Malibushko/TrackNode/applications/win/preview.png

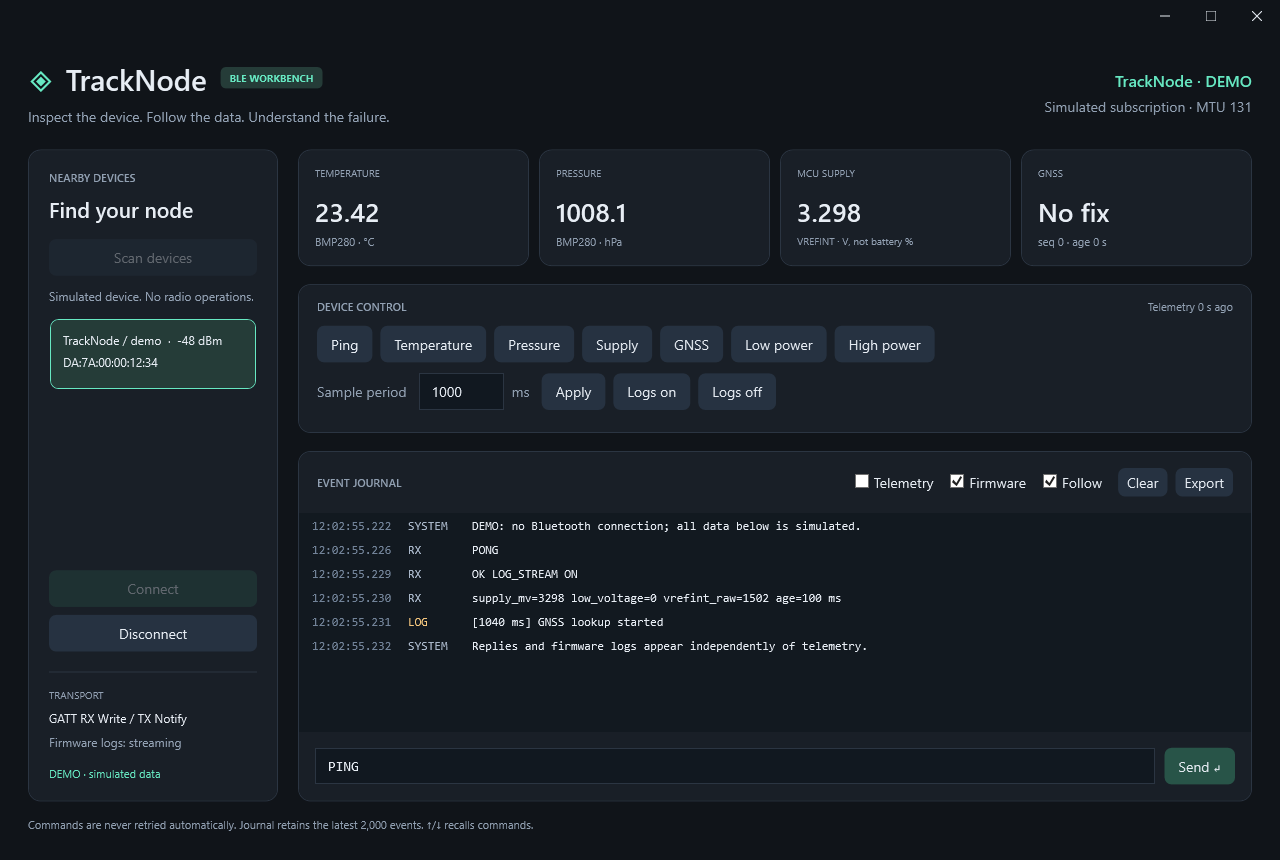
applications/win/preview.png
