Malibushko/TrackNode/hardware/enclosure/tracknode-explode.gif

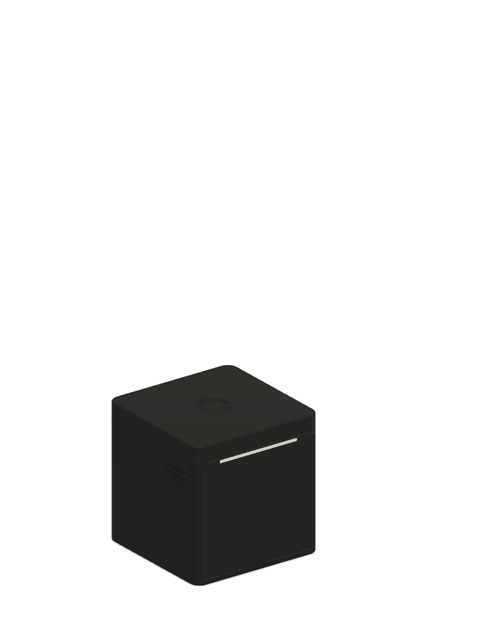
hardware/enclosure/tracknode-explode.gif
