Malibushko/TrackNode/hardware/enclosure/step/tracknode-main-board.step

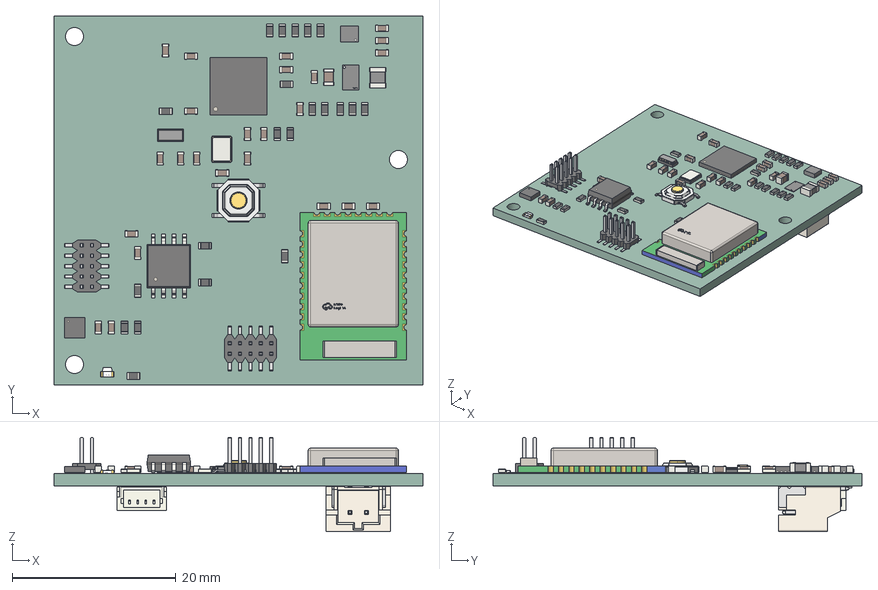
[picture p3: CAD file, 2026-10-30]
hardware/enclosure/step/tracknode-main-board.step
45.0 x 45.0 x 11.5 mm
LED-SMD_L1.7-W0.6-H1.2
R_0603_1608Metric x 21
HDR-SMD_10P-P1.27-M-LS-2X5P x 2
C_0603_1608Metric x 24
Crystal_SMD_3225-4Pin_3.2x2.5mm
Bosch_LGA_8_25x25mm_P065mm_ClockwisePinNumbering
C_0805_2012Metric
L_1008_2520Metric
WSON-10_L2.2-W2.0-P0.40-BL-EP_TI_DLH0010A
QFN-48-1EP_7x7mm_Pitch0.5mm
SOIC-8_5.3x5.3mm_P1.27mm
WIRELM-SMD_L18.0-W13.0-H3.0-E73-2G4M08S1C
Crystal_SMD_3215-2Pin_3.2x1.5mm
VSON-10_L3.0-W2.0-P0.50-TL
SW-SMD_4P-L5.1-W5.1-P3.70-LS6.5-TL_H1.5
JST_SH_SM04B-SRSS-TB_1x04-1MP_P1.00mm_Horizontal
CONN-SMD_P2.00_S2B-PH-SM4-TB-LF-SN
track-node_PCB
