Malibushko/TrackNode/hardware/enclosure/stl/tracknode-lid.stl

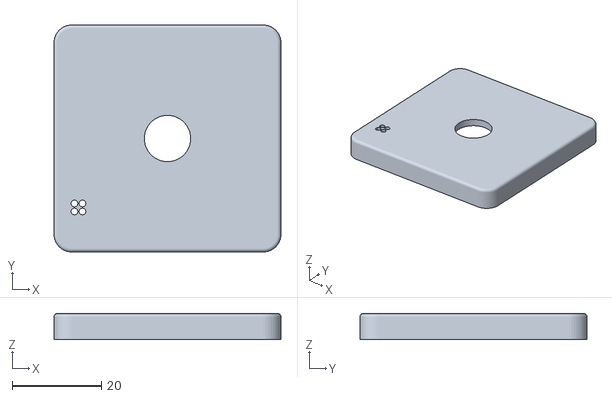
[picture p4: CAD file, 2026-10-30]
hardware/enclosure/stl/tracknode-lid.stl
51.0 x 51.0 x 5.90
