Malibushko/TrackNode/hardware/enclosure/step/tracknode-usb-board.step

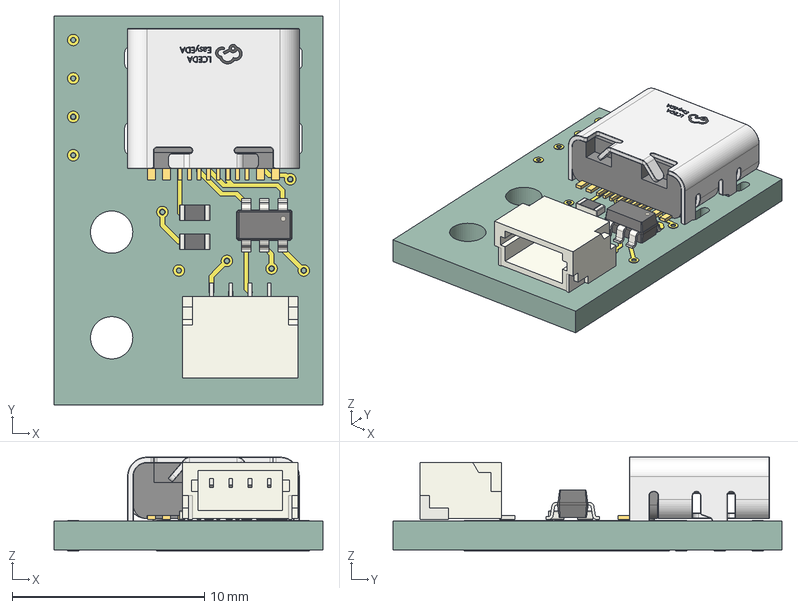
[picture p5: CAD file, 2026-10-30]
hardware/enclosure/step/tracknode-usb-board.step
14.0 x 20.2 x 4.88 mm
R_0603_1608Metric x 2
USB-C_SMD-TYPE-C-31-M-12
JST_SH_SM04B-SRSS-TB_1x04-1MP_P1.00mm_Horizontal
SOT-23-6
track-node-usb_copper
track-node-usb_via
track-node-usb_PCB
