Malibushko/TrackNode/hardware/enclosure/stl/tracknode-light-bar.stl

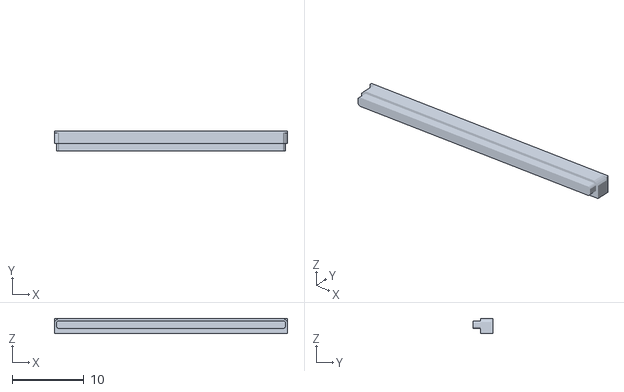
[picture p6: CAD file, 2026-10-30]
hardware/enclosure/stl/tracknode-light-bar.stl
32.4 x 2.75 x 2.05
