Malibushko/TrackNode/hardware/enclosure/stl/tracknode-battery-strap.stl

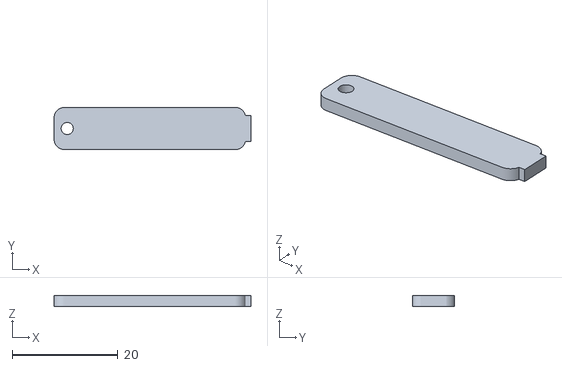
[picture p7: CAD file, 2026-10-30]
hardware/enclosure/stl/tracknode-battery-strap.stl
37.3 x 8.00 x 2.00
