Malibushko/TrackNode/hardware/enclosure/stl/tracknode-button-cap.stl

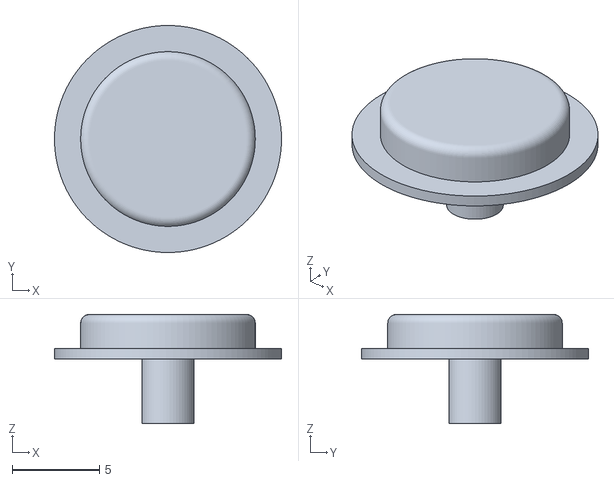
[picture p8: CAD file, 2026-10-30]
hardware/enclosure/stl/tracknode-button-cap.stl
13.0 x 13.0 x 6.25
