Malibushko/TrackNode/hardware/enclosure/stl/tracknode-front-plate.stl

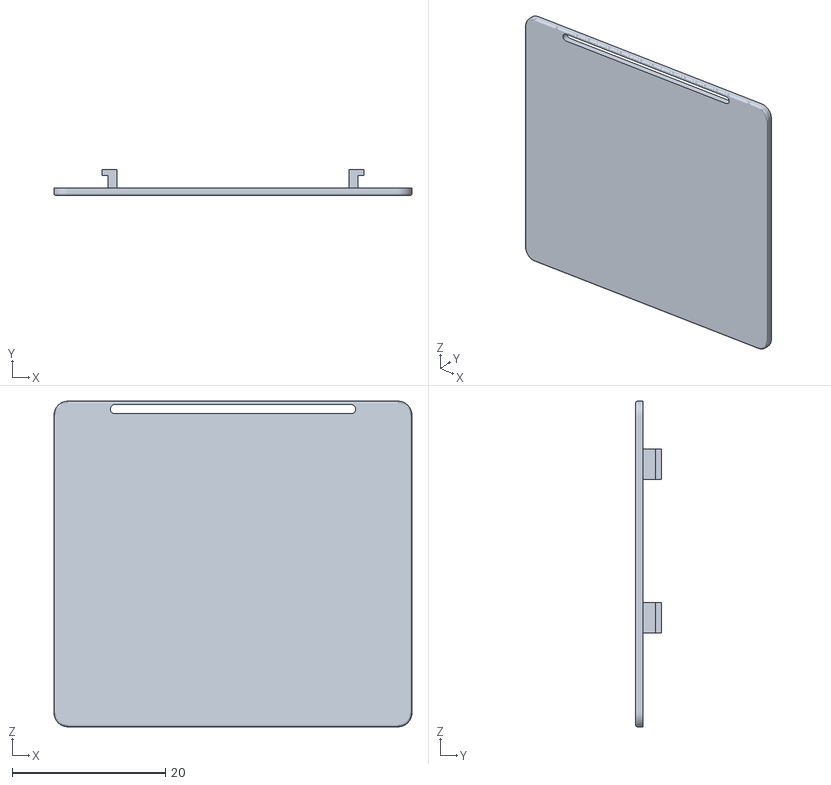
[picture p9: CAD file, 2026-10-30]
hardware/enclosure/stl/tracknode-front-plate.stl
46.7 x 3.40 x 42.5
