Malibushko/TrackNode/hardware/enclosure/stl/tracknode-body.stl

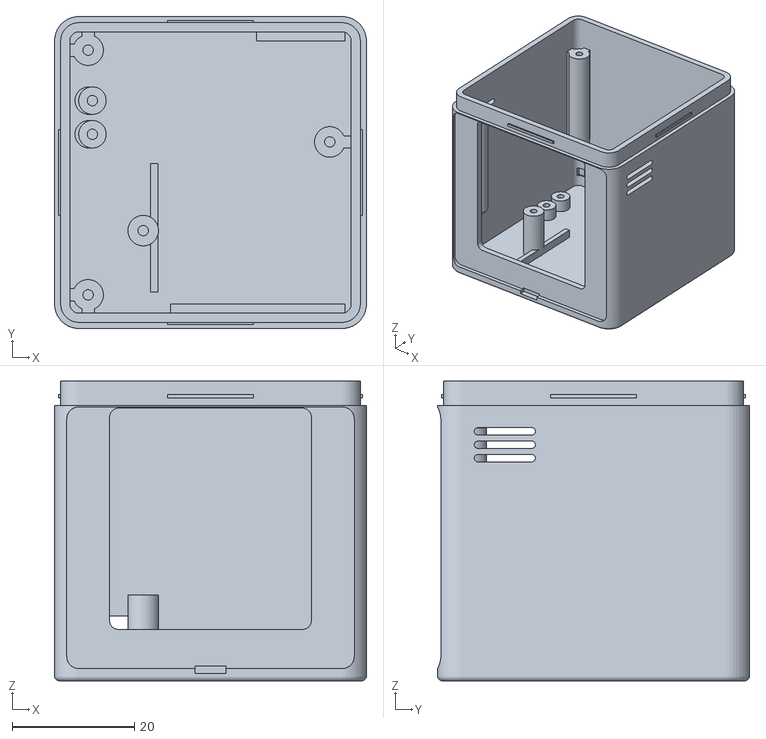
[picture p10: CAD file, 2026-10-30]
hardware/enclosure/stl/tracknode-body.stl
51.0 x 51.0 x 49.0
