Malibushko/TrackNode/(list of files, cad)

Other CAD files:
hardware/enclosure/tracknode-enclosure.f3d
