Malibushko/TrackNode/hardware/kicad/track-node-usb/track-node-usb.kicad_pcb

## KiCad design hardware/kicad/track-node-usb/track-node-usb.kicad_pcb (2026-10-30)

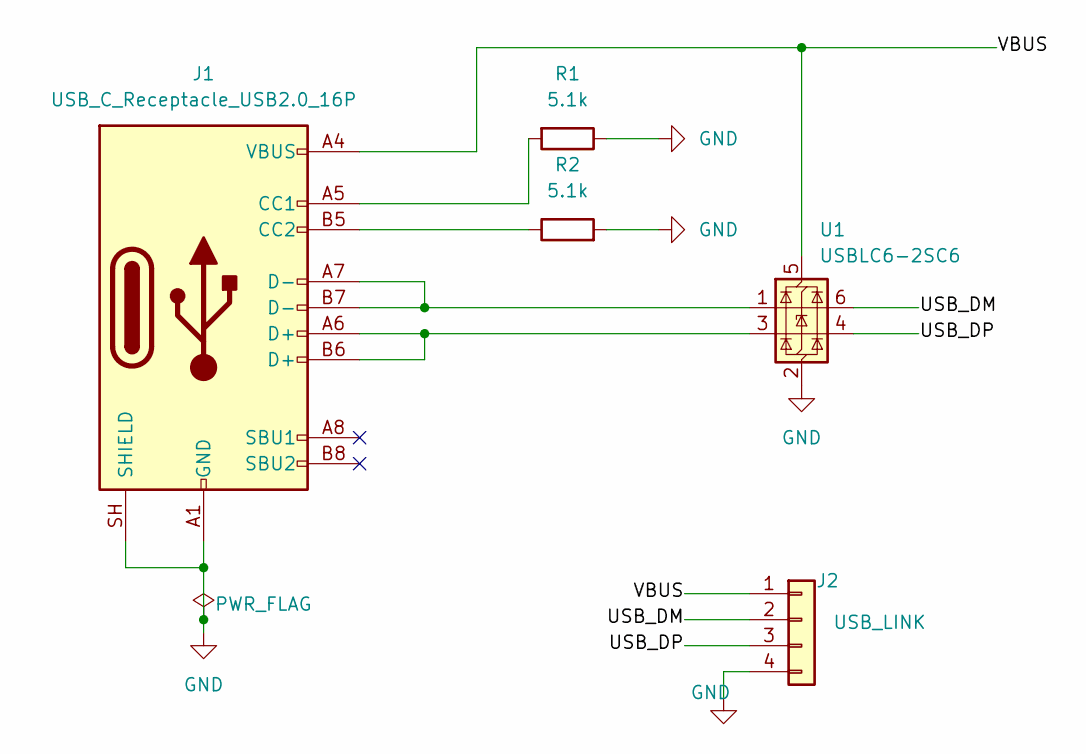
[picture p11: schematic track-node-usb.kicad_sch]

Parts:
J1: USB_C_Receptacle_USB2.0_16P; USB_C_Receptacle_HRO_TYPE-C-31-M-12_Edge; LCSC C165948
J2: USB_LINK; JST_SH_SM04B-SRSS-TB_1x04-1MP_P1.00mm_Horizontal; LCSC C160404
R1, R2: 5.1k; R_0603_1608Metric; LCSC C23186
U1: USBLC6-2SC6; SOT-23-6; LCSC C7519

Connections:
/USB_DM: J2.2, U1.6 (I/O1)
/USB_DP: J2.3, U1.4 (I/O2)
/VBUS: J1.A4 (VBUS), J1.A9 (VBUS), J1.B4 (VBUS), J1.B9 (VBUS), J2.1, U1.5 (VBUS)
GND: J1.A1 (GND), J1.A12 (GND), J1.B1 (GND), J1.B12 (GND), J1.SH (SHIELD), J2.4, R1.1, R2.2, U1.2 (GND)
unnamed: J1.A5 (CC1), R1.2
unnamed: J1.B5 (CC2), R2.1
unnamed: J1.A6 (D+), J1.B6 (D+), U1.3 (I/O2)
unnamed: J1.A7 (D-), J1.B7 (D-), U1.1 (I/O1)

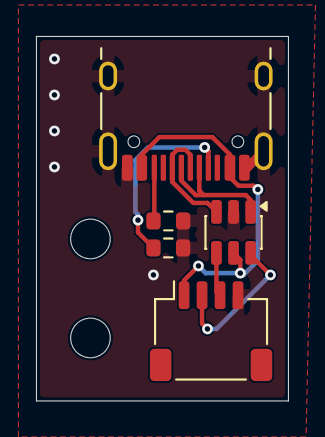
[picture p12: board track-node-usb.kicad_pcb from above]

Board: 2 copper layers, 14.0 x 20.2 mm, 5 parts (0 on the bottom side), 8 nets.
