Malibushko/TrackNode/hardware/kicad/track-node/track-node.kicad_pcb

## KiCad design hardware/kicad/track-node/track-node.kicad_pcb (2026-10-30)

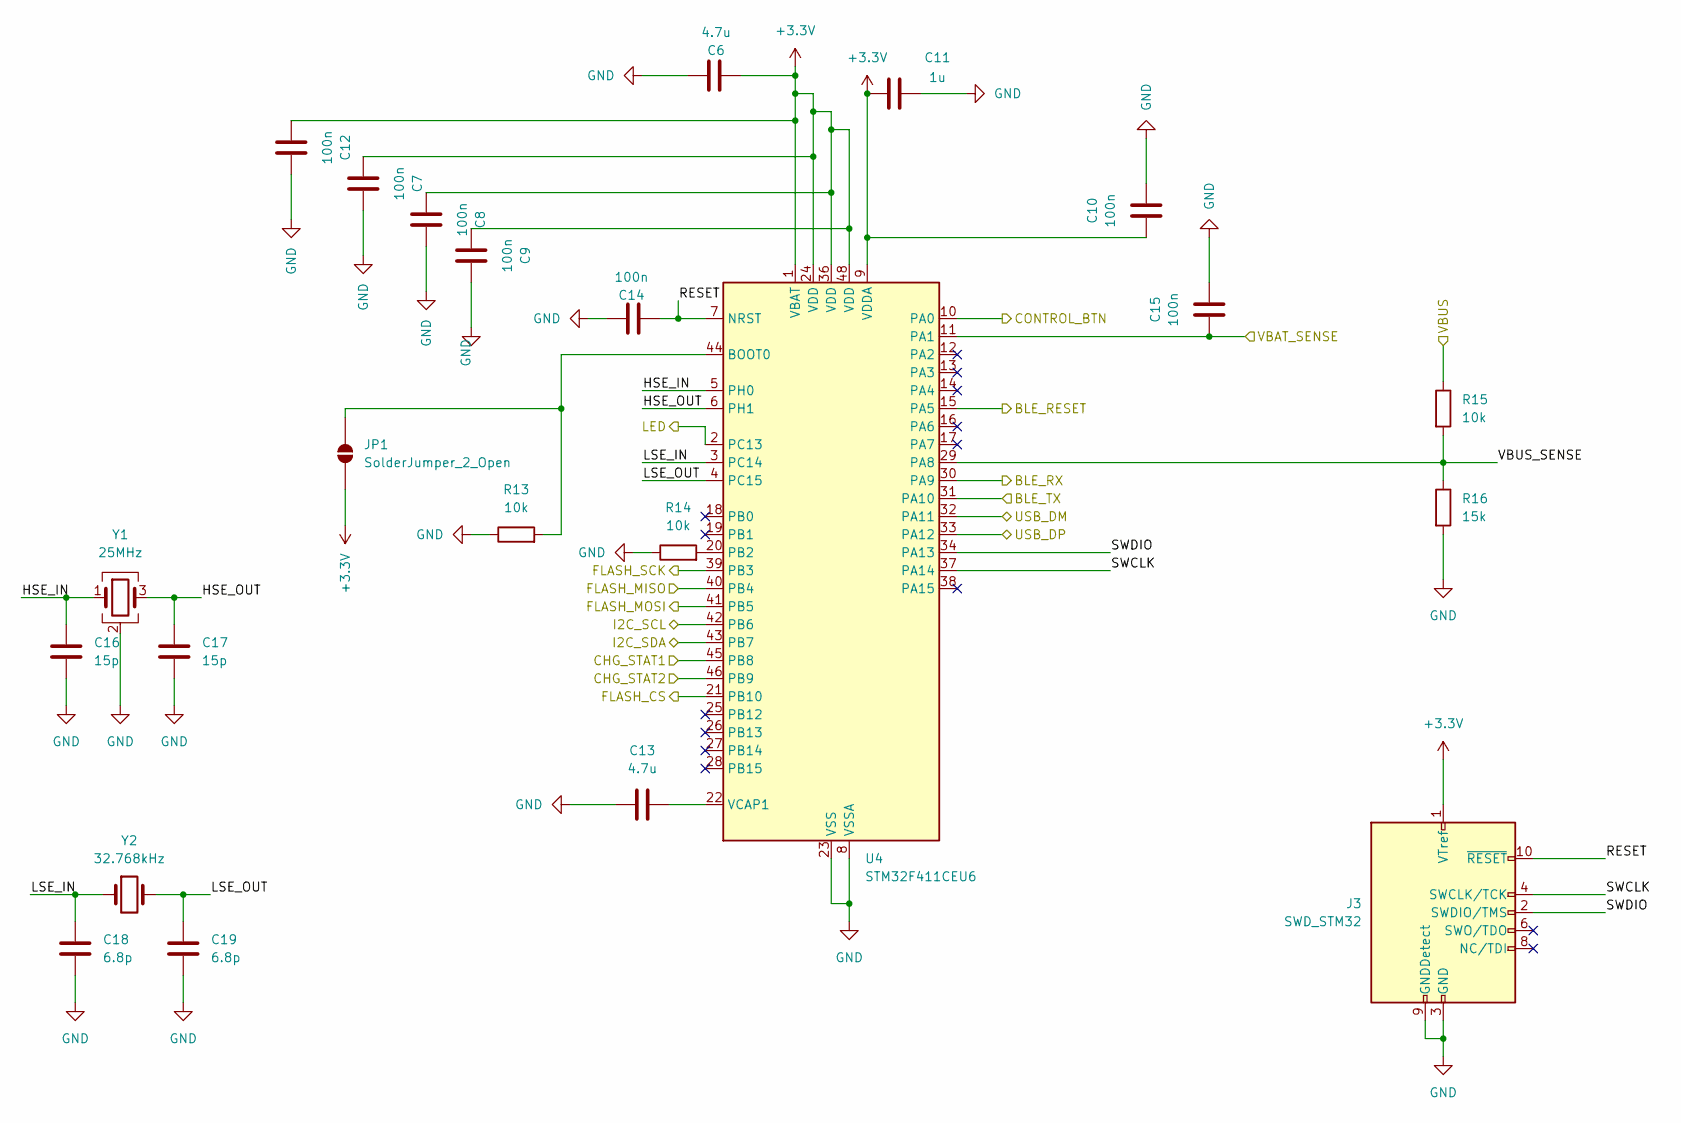
[picture p13: schematic MCU.kicad_sch]

Parts:
C6, C13: 4.7u; C_0603_1608Metric; LCSC C19666
C7, C8, C9, C10, C12, C14, C15: 100n; C_0603_1608Metric; LCSC C14663
C11: 1u; C_0603_1608Metric; LCSC C15849
C16, C17: 15p; C_0603_1608Metric; LCSC C1644
C18, C19: 6.8p; C_0603_1608Metric; LCSC C1679
J3: SWD_STM32; HDR-SMD_10P-P1.27-V-M-R2-C5-S1.27-LS5.5; LCSC C598540
JP1: SolderJumper_2_Open; SolderJumper-2_P1.3mm_Open_RoundedPad1.0x1.5mm
R13, R14, R15: 10k; R_0603_1608Metric; LCSC C25804
R16: 15k; R_0603_1608Metric; LCSC C22809
U4: STM32F411CEU6; QFN-48-1EP_7x7mm_P0.5mm_EP5.6x5.6mm; LCSC C60420
Y1: 25MHz; Crystal_SMD_3225-4Pin_3.2x2.5mm; LCSC C9006
Y2: 32.768kHz; Crystal_SMD_3215-2Pin_3.2x1.5mm; LCSC C276424

Connections:
+3.3V: C6.2, C7.2, C8.2, C9.2, C10.2, C11.2, C12.2, J3.1 (VTref), JP1.1 (A), U4.1 (VBAT), U4.9 (VDDA), U4.24 (VDD), U4.36 (VDD), U4.48 (VDD); also elsewhere on the board
/BLE/BLE_RESET: U4.15 (PA5); also elsewhere on the board
/BLE/BLE_RX: U4.30 (PA9); also elsewhere on the board
/BLE/BLE_TX: U4.31 (PA10); also elsewhere on the board
/MCU/CHG_STAT1: U4.45 (PB8); also elsewhere on the board
/MCU/CHG_STAT2: U4.46 (PB9); also elsewhere on the board
/MCU/CONTROL_BTN: U4.10 (PA0); also elsewhere on the board
/MCU/FLASH_CS: U4.21 (PB10); also elsewhere on the board
/MCU/FLASH_MISO: U4.40 (PB4); also elsewhere on the board
/MCU/FLASH_MOSI: U4.41 (PB5); also elsewhere on the board
/MCU/FLASH_SCK: U4.39 (PB3); also elsewhere on the board
/MCU/HSE_IN: C16.1, U4.5 (PH0), Y1.1
/MCU/HSE_OUT: C17.1, U4.6 (PH1), Y1.3
/MCU/I2C_SCL: U4.42 (PB6); also elsewhere on the board
/MCU/I2C_SDA: U4.43 (PB7); also elsewhere on the board
/MCU/LED: U4.2 (PC13); also elsewhere on the board
/MCU/LSE_IN: C18.1, U4.3 (PC14), Y2.1
/MCU/LSE_OUT: C19.1, U4.4 (PC15), Y2.2
/MCU/RESET: C14.2, J3.10 (~RESET), U4.7 (NRST)
/MCU/SWCLK: J3.4 (SWCLK/TCK), U4.37 (PA14)
/MCU/SWDIO: J3.2 (SWDIO/TMS), U4.34 (PA13)
/MCU/USB_DM: U4.32 (PA11); also elsewhere on the board
/MCU/USB_DP: U4.33 (PA12); also elsewhere on the board
/MCU/VBAT_SENSE: C15.2, U4.11 (PA1); also elsewhere on the board
/MCU/VBUS: R15.1; also elsewhere on the board
/MCU/VBUS_SENSE: R15.2, R16.1, U4.29 (PA8)
GND: C6.1, C7.1, C8.1, C9.1, C10.1, C11.1, C12.1, C13.1, C14.1, C15.1, C16.2, C17.2, C18.2, C19.2, J3.3 (GND), J3.5 (GND), J3.9 (GNDDetect), R13.1, R14.1, R16.2, U4.8 (VSSA), U4.23 (VSS), U4.35 (VSS), U4.47 (VSS), U4.49 (VSS), Y1.2 (G), Y1.4 (G); also elsewhere on the board
unnamed: JP1.2 (B), R13.2, U4.44 (BOOT0)
unnamed: R14.2, U4.20 (PB2)
unnamed: C13.2, U4.22 (VCAP1)

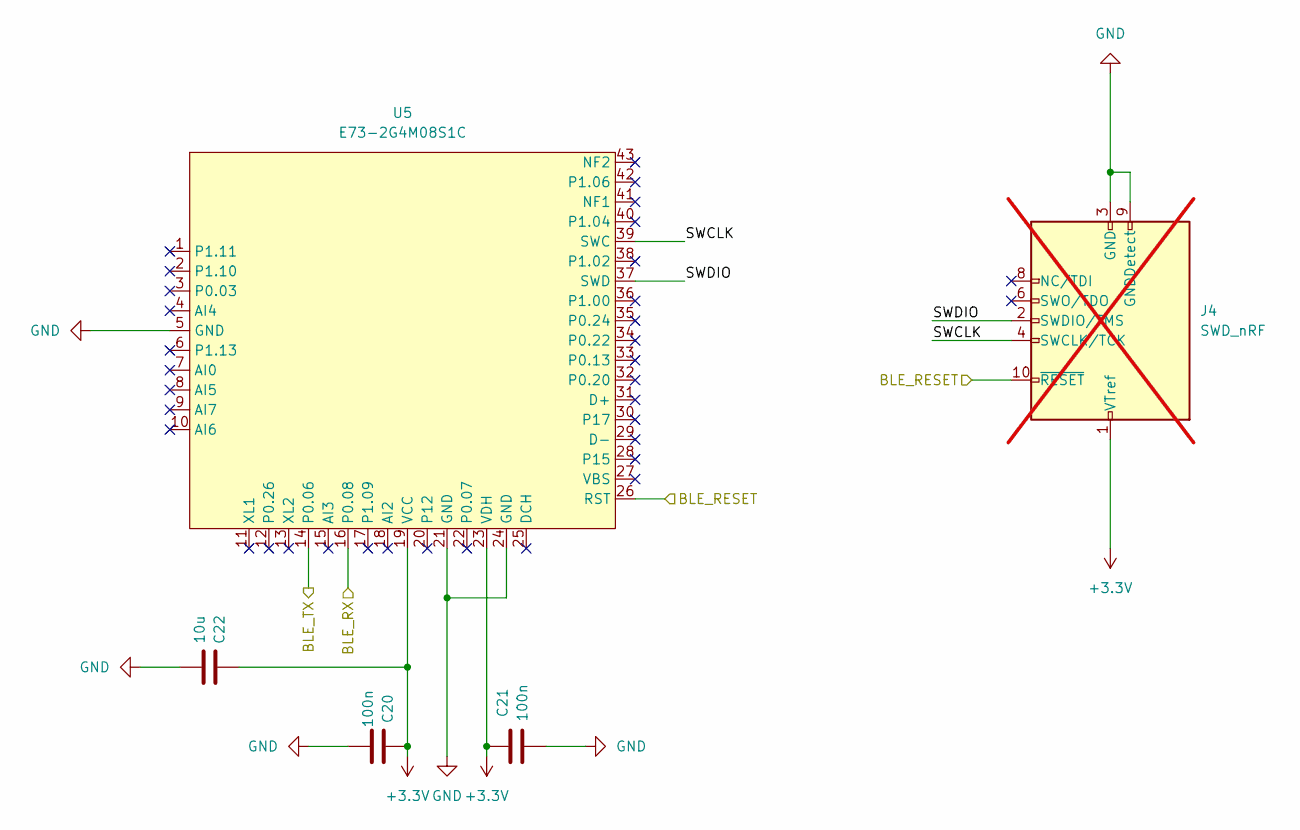
[picture p14: schematic BLE.kicad_sch]

Parts:
C20, C21: 100n; C_0603_1608Metric; LCSC C14663
C22: 10u; C_0603_1608Metric; LCSC C19702
J4: SWD_nRF; HDR-SMD_10P-P1.27-V-M-R2-C5-S1.27-LS5.5; not fitted
U5: E73-2G4M08S1C; WIRELM-SMD_E73-2G4M08S1C; MPN E73-2G4M08S1C; LCSC Part C356849

Connections:
+3.3V: C20.2, C21.2, C22.2, J4.1 (VTref), U5.19 (VCC), U5.23 (VDH); also elsewhere on the board
/BLE/BLE_RESET: J4.10 (~RESET), U5.26 (RST); also elsewhere on the board
/BLE/BLE_RX: U5.16 (P0.08); also elsewhere on the board
/BLE/BLE_TX: U5.14 (P0.06); also elsewhere on the board
/BLE/SWCLK: J4.4 (SWCLK/TCK), U5.39 (SWC)
/BLE/SWDIO: J4.2 (SWDIO/TMS), U5.37 (SWD)
GND: C20.1, C21.1, C22.1, J4.3 (GND), J4.5 (GND), J4.9 (GNDDetect), U5.5 (GND), U5.21 (GND), U5.24 (GND); also elsewhere on the board

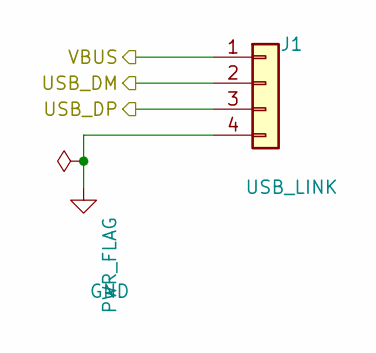
[picture p15: schematic USB.kicad_sch]

Parts:
J1: USB_LINK; JST_SH_SM04B-SRSS-TB_1x04-1MP_P1.00mm_Horizontal; LCSC C160404

Connections:
/MCU/USB_DM: J1.2; also elsewhere on the board
/MCU/USB_DP: J1.3; also elsewhere on the board
/MCU/VBUS: J1.1; also elsewhere on the board
GND: J1.4; also elsewhere on the board

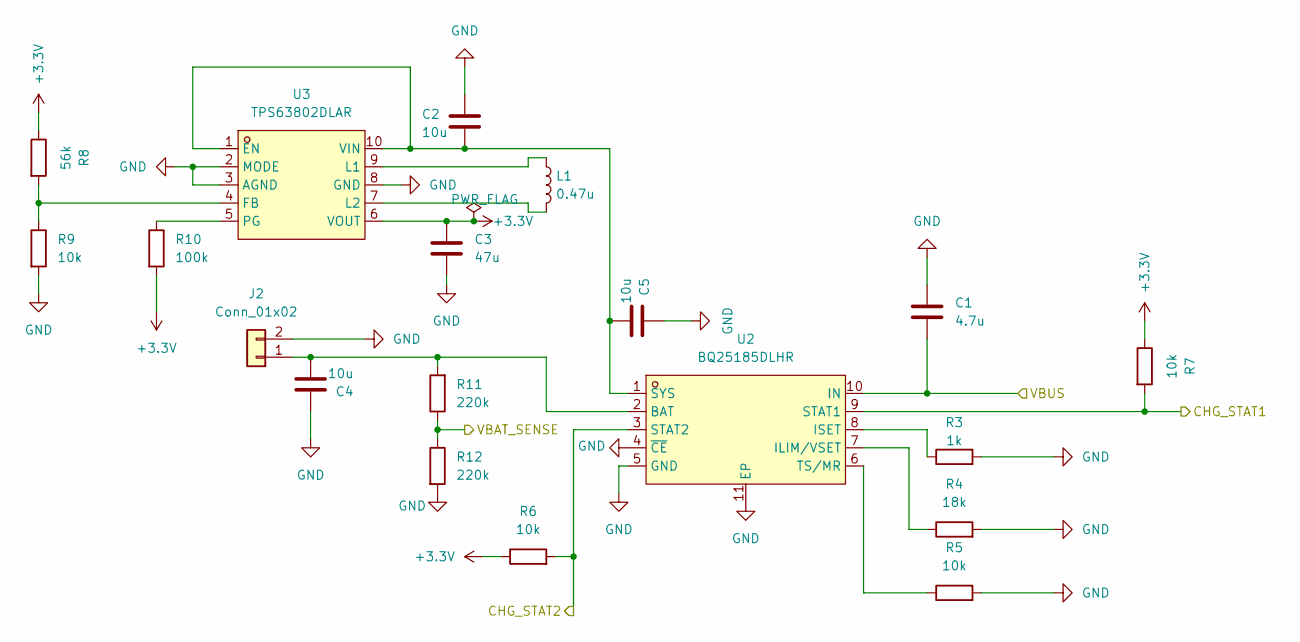
[picture p16: schematic Power.kicad_sch]

Parts:
C1: 4.7u; C_0603_1608Metric; LCSC C19666
C2, C4, C5: 10u; C_0603_1608Metric; LCSC C19702
C3: 47u; C_0805_2012Metric; LCSC C16780
J2: Conn_01x02; JST_PH_S2B-PH-SM4-TB_1x02-1MP_P2.00mm_Horizontal; LCSC C295747
L1: 0.47u; L_1008_2520Metric; LCSC C326159
R3: 1k; R_0603_1608Metric; LCSC C21190
R4: 18k; R_0603_1608Metric; LCSC C25810
R5, R6, R7, R9: 10k; R_0603_1608Metric; LCSC C25804
R8: 56k; R_0603_1608Metric; LCSC C23206
R10: 100k; R_0603_1608Metric; LCSC C25803
R11, R12: 220k; R_0603_1608Metric; LCSC C22961
U2: BQ25185DLHR; WSON-10_L2.2-W2.0-P0.40-BL-EP_TI_DLH0010A; MPN BQ25185DLHR; LCSC Part C19725033
U3: TPS63802DLAR; VSON-10_L3.0-W2.0-P0.50-TL; MPN TPS63802DLAR; LCSC Part C2845237

Connections:
+3.3V: C3.1, R6.1, R7.1, R8.1, R10.2, U3.6 (VOUT); also elsewhere on the board
/MCU/CHG_STAT1: R7.2, U2.9 (STAT1); also elsewhere on the board
/MCU/CHG_STAT2: R6.2, U2.3 (STAT2); also elsewhere on the board
/MCU/VBAT_SENSE: R11.1, R12.1; also elsewhere on the board
/MCU/VBUS: C1.2, U2.10 (IN); also elsewhere on the board
GND: C1.1, C2.1, C3.2, C4.1, C5.1, J2.2, R3.2, R4.2, R5.2, R9.2, R12.2, U2.4 (~CE), U2.5 (GND), U2.11 (EP), U3.2 (MODE), U3.3 (AGND), U3.8 (GND); also elsewhere on the board
unnamed: C4.2, J2.1, R11.2, U2.2 (BAT)
unnamed: R4.1, U2.7 (ILIM/VSET)
unnamed: R3.1, U2.8 (ISET)
unnamed: C2.2, C5.2, U2.1 (SYS), U3.1 (EN), U3.10 (VIN)
unnamed: R5.1, U2.6 (TS/MR)
unnamed: R8.2, R9.1, U3.4 (FB)
unnamed: L1.1, U3.9 (L1)
unnamed: L1.2, U3.7 (L2)
unnamed: R10.1, U3.5 (PG)

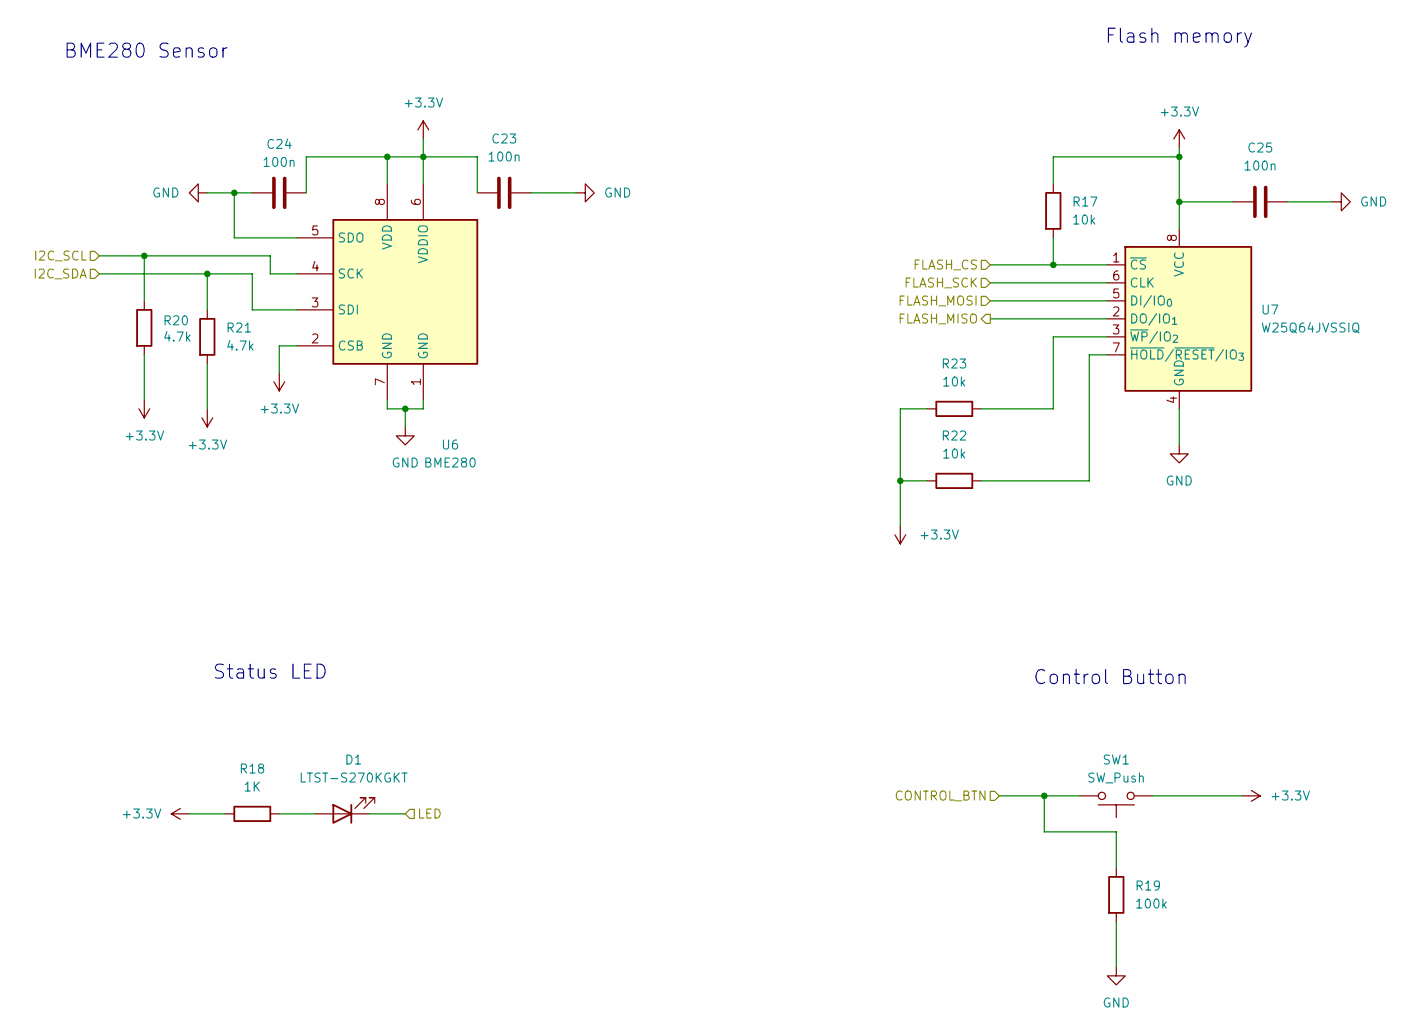
[picture p17: schematic Peripherals.kicad_sch]

Parts:
C23, C24, C25: 100n; C_0603_1608Metric; LCSC C14663
D1: LTST-S270KGKT; LED-SMD_L1.7-W0.6-RD; LCSC C125113
R17, R22, R23: 10k; R_0603_1608Metric; LCSC C25804
R18: 1K; R_0603_1608Metric; LCSC C21190
R19: 100k; R_0603_1608Metric; LCSC C25803
R20, R21: 4.7k; R_0603_1608Metric; LCSC C23162
SW1: SW_Push; SW-SMD_4P-L5.1-W5.1-P3.70-LS6.5-TL_H1.5; LCSC C318884
U6: BME280; Bosch_LGA-8_2.5x2.5mm_P0.65mm_ClockwisePinNumbering; LCSC C92489
U7: W25Q64JVSSIQ; SOIC-8_5.3x5.3mm_P1.27mm; LCSC C179171

Connections:
+3.3V: C23.1, C24.1, C25.1, R17.1, R18.1, R20.2, R21.2, R22.1, R23.1, SW1.1, U6.2 (CSB), U6.6 (VDDIO), U6.8 (VDD), U7.8 (VCC); also elsewhere on the board
/MCU/CONTROL_BTN: R19.1, SW1.2; also elsewhere on the board
/MCU/FLASH_CS: R17.2, U7.1 (~CS); also elsewhere on the board
/MCU/FLASH_MISO: U7.2 (DO/IO_{1}); also elsewhere on the board
/MCU/FLASH_MOSI: U7.5 (DI/IO_{0}); also elsewhere on the board
/MCU/FLASH_SCK: U7.6 (CLK); also elsewhere on the board
/MCU/I2C_SCL: R20.1, U6.4 (SCK); also elsewhere on the board
/MCU/I2C_SDA: R21.1, U6.3 (SDI); also elsewhere on the board
/MCU/LED: D1.1 (K); also elsewhere on the board
GND: C23.2, C24.2, C25.2, R19.2, U6.1 (GND), U6.5 (SDO), U6.7 (GND), U7.4 (GND); also elsewhere on the board
unnamed: D1.2 (A), R18.2
unnamed: R22.2, U7.7 (~HOLD/~RESET/IO_{3})
unnamed: R23.2, U7.3 (~WP/IO_{2})

Notes on the sheet:
Control Button
Status LED
BME280 Sensor
Flash memory

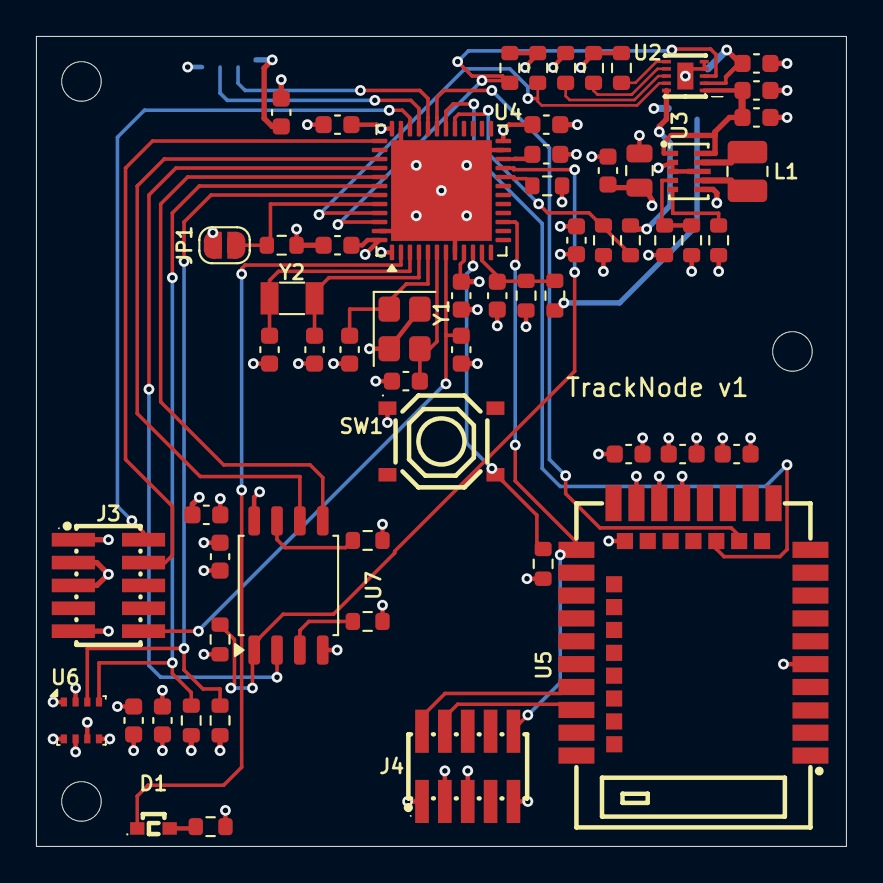
[picture p18: board track-node.kicad_pcb from above]

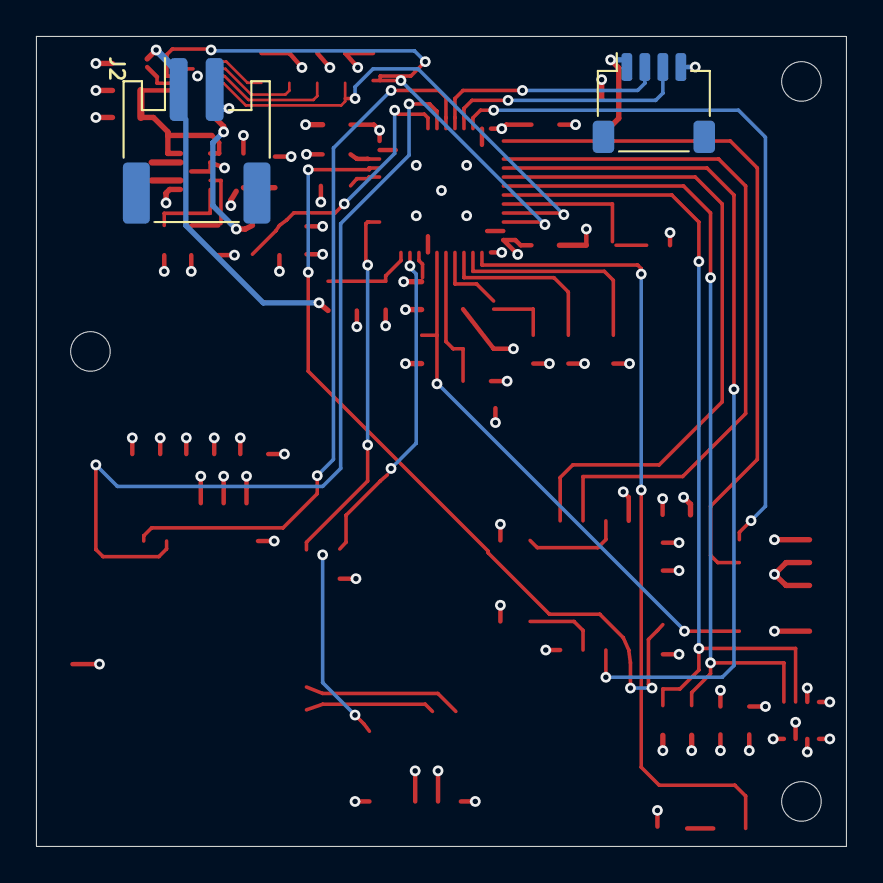
[picture p19: board track-node.kicad_pcb from below]

Board: 4 copper layers, 45.0 x 45.0 mm, 62 parts (2 on the bottom side), 44 nets.
