Malibushko/TrackNode/src/composition/main.cpp

#include "application/deferred_command_sink.h"
#include "application/telemetry_router.h"
#include "infrastructure/telemetry_journal_service.h"
#include "composition/track_node.h"
#include "board/clock.h"
#include "platform/error.h"
#include "platform/hardware.h"
#include "platform/low_power.h"
#include "platform/power_stats.h"
#include "application/node_controller.h"
#include "drivers/devices/neo6m.h"
#include "drivers/devices/w25qxx.h"
#include "drivers/gpio_interrupt.h"
#include "drivers/spi_bus.h"
#include "drivers/uart.h"
#include "drivers/usb_cdc_serial_device.h"
#include "infrastructure/console_service.h"
#include "infrastructure/logger_service.h"
#include "infrastructure/sensor_service.h"
#include "infrastructure/battery_service.h"
#include "infrastructure/control_button_service.h"
#include "infrastructure/gnss_service.h"

#if TRACK_NODE_ENABLE_LORA
#include "application/radio_telemetry_filter.h"
#include "drivers/devices/sx126x.h"
#include "infrastructure/radio_service.h"
#endif
#if TRACK_NODE_ENABLE_BLUETOOTH
#include "drivers/devices/xiao_ble_bridge.h"
#include "infrastructure/bluetooth_service.h"
#endif
#ifndef NO_STORAGE
#include "infrastructure/storage_service.h"
#endif

class storage_service;

//////////////////////////////////////////////////////////////////////////

struct firmware_composition
{
	component_list devices;
	service_list services;
	telemetry_router<2> telemetry;
	telemetry_journal_service *journal = nullptr;
	deferred_command_sink commands;

	supervisor *monitor = nullptr;
	logger_service *logger = nullptr;
	sensor_service *measurements = nullptr;
	indicator_service *indicator = nullptr;
	gnss_service *gnss = nullptr;
	storage_service *records = nullptr;

	bluetooth_service *bluetooth = nullptr;
	track_node *runtime = nullptr;
};

//////////////////////////////////////////////////////////////////////////

bool usb_keeps_clocks_running(const void *context)
{
	return static_cast<const usb_device *>(context)->attached();
}

//////////////////////////////////////////////////////////////////////////

#if TRACK_NODE_ENABLE_BLUETOOTH
bool bridge_uart_keeps_clocks_running(const void *context)
{
	const auto &bridge = *static_cast<const uart *>(context);
	const auto peer_exchange_recent = bridge.idle_ticks() < pdMS_TO_TICKS(ble_bridge::receiver_awake_hold_ms);
	return bridge.transmitting() || peer_exchange_recent;
}
#endif

//////////////////////////////////////////////////////////////////////////

status initialize_platform()
{
	HAL_Init();
	power_stats::start();
#ifdef TRACK_NODE_DEBUG_IN_SLEEP
	HAL_DBGMCU_EnableDBGSleepMode();
#endif

	return init_system_clock();
}

//////////////////////////////////////////////////////////////////////////

spi_bus &telemetry_flash_bus()
{
	static spi_bus bus{spi_bus_config{
	    .instance = SPI1,
	    .baud_rate_prescaler = SPI_BAUDRATEPRESCALER_8,
	    .pin_sck = {GPIOB, GPIO_PIN_3},
	    .pin_miso = {GPIOB, GPIO_PIN_4},
	    .pin_mosi = {GPIOB, GPIO_PIN_5}
	}};
	return bus;
}

//////////////////////////////////////////////////////////////////////////

status configure_telemetry_journal(firmware_composition &application)
{
	static w25qxx flash{telemetry_flash_bus(), spi_device_config{
	    .cs_pin = {GPIOB, GPIO_PIN_10}
	}};
	static telemetry_journal_service journal{application.telemetry, flash, telemetry_archive_config{}, {
		HAL_GetUIDw0(),
		HAL_GetUIDw1(),
		HAL_GetUIDw2()
	}};
	if (auto added = application.devices.add("storage_bus", telemetry_flash_bus(), component_startup::initialize)
	    .and_then([&]{ return application.devices.add("telemetry_journal", journal, component_startup::initialize); }); !added)
	{
		return added;
	}
	application.journal = &journal;
	return {};
}

//////////////////////////////////////////////////////////////////////////

status configure_watchdog(firmware_composition &application)
{
	static watchdog device{watchdog_config{
	    .instance = IWDG,
	    .prescaler = IWDG_PRESCALER_256,
	    .reload = 0xFFF
	}};

	if (auto added = application.devices.add("watchdog", device, component_startup::defer); !added)
	{
		return added;
	}

	static supervisor monitor{device};

	if (auto added = application.services.add(service_id::watchdog, monitor, {service_id::sensor}); !added)
	{
		return added;
	}

	application.monitor = &monitor;

	return {};
}

//////////////////////////////////////////////////////////////////////////

status configure_console(firmware_composition &application)
{
	if (!application.monitor)
	{
		return fail(component::service, error_code::invalid_config);
	}

	static usb_device device{usb_device_config{
		.vendor_id = TRACK_NODE_USB_VID,
		.product_id = TRACK_NODE_USB_PID,
		.manufacturer = "TrackNode",
		.product = "TrackNode Console",
		.vbus = {GPIOA, GPIO_PIN_8}
	}};
	static usb_cdc cdc{device};
	static usb_cdc_serial_device transport{cdc};
	static gpio_interrupt vbus_edges{gpio_interrupt_config{
		.pin = {GPIOA, GPIO_PIN_8}
	}};
	auto added = application.devices.add("usb_device", device, component_startup::initialize)
		.and_then([&]{ return application.devices.add("usb_cdc", cdc, component_startup::initialize); })
		.and_then([&]{ return application.devices.add("console_transport", transport, component_startup::initialize); })
		.and_then([&]{ return application.devices.add("vbus_edges", vbus_edges, component_startup::initialize); })
		.and_then([&]{ return low_power::add_stop_veto(usb_keeps_clocks_running, &device); });
	if (!added)
	{
		return added;
	}

	static logger_service logger{transport, *application.monitor};

	if (auto added = application.services.add(service_id::logger, logger); !added)
	{
		return added;
	}

	application.logger = &logger;
	static task_event_source *const console_wake_sources[]{&transport, &vbus_edges};
	static console_service console{transport, application.commands, logger, *application.monitor, console_wake_sources};
	return application.services.add(service_id::console, console, {service_id::sensor});
}

//////////////////////////////////////////////////////////////////////////

status configure_sensors(firmware_composition &application)
{
	static i2c_bus bus{i2c_bus_config{
	    .instance = I2C1,
	    .clock_speed = 100000,
	    .pin_scl = {GPIOB, GPIO_PIN_6},
	    .pin_sda = {GPIOB, GPIO_PIN_7}
	}};

	static i2c_device transport{bus, 0x76};
	static bmp280 sensor{transport, bmp280::config{
	    .mode = bmp280::run_mode::forced,
	    .filter = bmp280::iir_filter::off
	}};

	auto added = application.devices.add("sensor_bus", bus, component_startup::initialize)
	    .and_then([&]{ return application.devices.add("sensor_transport", transport, component_startup::defer); })
	    .and_then([&]{ return application.devices.add("sensor", sensor, component_startup::defer); });

	if (!added)
	{
		return added;
	}

	static sensor_service measurements{sensor};
	application.measurements = &measurements;

	return {};
}

//////////////////////////////////////////////////////////////////////////

status configure_indicator(firmware_composition &application)
{
	if (!application.logger || !application.monitor)
	{
		return fail(component::service, error_code::invalid_config);
	}

	static indicator_service indicator{*application.logger, *application.monitor};

	if (auto added = application.services.add(service_id::indicator, indicator, {service_id::logger}); !added)
	{
		return added;
	}

	application.indicator = &indicator;

	return {};
}

//////////////////////////////////////////////////////////////////////////

status configure_gnss(firmware_composition &application)
{
#if TRACK_NODE_ENABLE_GNSS
	if (!application.logger || !application.monitor)
	{
		return fail(component::service, error_code::invalid_config);
	}

	static uart transport{uart_config{
	    .instance = USART2,
	    .tx = {GPIOA, GPIO_PIN_2},
	    .rx = {GPIOA, GPIO_PIN_3},
	    .alternate = GPIO_AF7_USART2,
	    .baud_rate = 9600,
	    .mode = UART_MODE_TX_RX
	}};

	static neo6m device{transport};

	auto added = application.devices.add("gps_transport", transport, component_startup::initialize)
	    .and_then([&]{ return application.devices.add("gps", device, component_startup::defer); });

	if (!added)
	{
		return added;
	}

	static gnss_service gnss{device, *application.logger, *application.monitor};

	if (auto registered = application.services.add(service_id::gnss, gnss, {service_id::logger}); !registered)
	{
		return registered;
	}

	application.gnss = &gnss;

	return {};
#else
	(void)application;

	return {};
#endif
}

//////////////////////////////////////////////////////////////////////////

status configure_storage(firmware_composition &application)
{
#ifndef NO_STORAGE
	if (!application.logger || !application.monitor)
	{
		return fail(component::service, error_code::invalid_config);
	}

	static sd_card card{telemetry_flash_bus(), spi_device_config{
	    .cs_pin = {GPIOA, GPIO_PIN_15}
	}};

	auto added = application.devices.add("storage", card, component_startup::defer);

	if (!added)
	{
		return added;
	}

	static storage_service records{card, storage_service::file_config{
	    "logs",
	    sample_csv_header
	},
	    *application.logger, *application.monitor};

	if (auto registered = application.services.add(service_id::storage, records, {service_id::logger}); !registered)
	{
		return registered;
	}

	application.records = &records;
#else
	(void)application;
#endif

	return {};
}

//////////////////////////////////////////////////////////////////////////

status configure_radio(firmware_composition &application)
{
#if TRACK_NODE_ENABLE_LORA
	if (!application.logger || !application.monitor)
	{
		return fail(component::service, error_code::invalid_config);
	}

	static spi_bus bus{spi_bus_config{
	    .instance = SPI2,
	    .baud_rate_prescaler = SPI_BAUDRATEPRESCALER_8,
	    .pin_sck = {GPIOB, GPIO_PIN_13},
	    .pin_miso = {GPIOB, GPIO_PIN_14},
	    .pin_mosi = {GPIOB, GPIO_PIN_15}
	}};

	static sx126x_driver device{bus, sx126x_config{
	    .nss = {GPIOB, GPIO_PIN_12},
	    .reset = {GPIOA, GPIO_PIN_4},
	    .busy = {GPIOB, GPIO_PIN_0},
	    .dio1 = {GPIOA, GPIO_PIN_5},
	    .txen = {GPIOA, GPIO_PIN_6},
	    .rxen = {GPIOA, GPIO_PIN_7},
	    .frequency_hz = 868'100'000,
	    .spreading_factor = 7,
	    .bandwidth = sx126x_lora_bandwidth::KHZ_125,
	    .coding_rate = sx126x_lora_coding_rate::CR_4_5,
	    .low_data_rate_optimization = false,
	    .preamble_symbols = 8,
	    .explicit_header = true,
	    .crc_enabled = true,
	    .invert_iq = false,
	    .sync_word = 0x1424,
	    .tx_power_dbm = 10
	}};

	auto added = application.devices.add("radio_bus", bus, component_startup::initialize)
	    .and_then([&]{ return application.devices.add("radio", device, component_startup::defer); });

	if (!added)
	{
		return added;
	}

	static radio_service radio{device, *application.logger, *application.monitor};
	static radio_telemetry_filter filtered_radio{radio};

	return application.services.add(service_id::radio, radio, {service_id::logger})
	    .and_then([&]{ return application.telemetry.add(filtered_radio); });
#else
	(void)application;

	return {};
#endif
}

//////////////////////////////////////////////////////////////////////////

status configure_bluetooth(firmware_composition &application)
{
#if TRACK_NODE_ENABLE_BLUETOOTH
	if (!application.logger || !application.monitor)
	{
		return fail(component::service, error_code::invalid_config);
	}

	static uart transport{uart_config{
	    .instance = USART1,
	    .tx = {GPIOA, GPIO_PIN_9},
	    .rx = {GPIOA, GPIO_PIN_10},
	    .alternate = GPIO_AF7_USART1,
	    .baud_rate = 115200,
	    .mode = UART_MODE_TX_RX,
	    .rx_buffer_size = 1024,
	    .rx_pull = GPIO_PULLUP,
	}};

	if (auto watched = low_power::add_stop_veto(bridge_uart_keeps_clocks_running, &transport)
	    .and_then([&]{ return low_power::add_wake_pin(transport.rx_pin()); }); !watched)
	{
		return watched;
	}

	static xiao_ble_bridge backend{transport};
	static bluetooth_service bluetooth{backend, application.commands, *application.logger, *application.monitor, bluetooth_config{}, application.indicator, application.journal};
	application.bluetooth = &bluetooth;

	return application.services.add(service_id::bluetooth, bluetooth, {service_id::logger})
	    .and_then([&]{ return application.telemetry.add(bluetooth); });
#else
	(void)application;

	return {};
#endif
}

//////////////////////////////////////////////////////////////////////////

status configure_control_button(firmware_composition &application)
{
	if (!application.bluetooth)
	{
		return {};
	}

	static constexpr std::uint32_t pairing_hold_ms = 5000;
	static constexpr std::uint32_t hold_thresholds_ms[]{pairing_hold_ms};
	static control_button_service button{control_button_config{
		.input = gpio_config{
			.pin = {GPIOA, GPIO_PIN_0},
			.mode = GPIO_MODE_INPUT,
			.pull = GPIO_PULLUP,
			.active_low = true
		},
		.poll_ms = 10,
		.debounce_ms = 30,
		.hold_thresholds_ms = hold_thresholds_ms,
		.pairing_hold_ms = pairing_hold_ms
	}, *application.bluetooth, *application.monitor};
	return application.services.add(service_id::control_button, button, {service_id::bluetooth});
}

//////////////////////////////////////////////////////////////////////////

status configure_controller(firmware_composition &application)
{
	if (!application.measurements || !application.indicator || !application.logger ||
	    !application.monitor || !application.journal || application.commands.bound())
	{
		return fail(component::service, error_code::invalid_config);
	}
#ifndef NO_STORAGE
	if (!application.records)
	{
		return fail(component::service, error_code::invalid_config);
	}
#endif

	static battery_service battery{battery_service::config{
		.battery_input = adc_config{
			.pin = {GPIOA, GPIO_PIN_1},
			.channel = ADC_CHANNEL_1,
			.sample_time = ADC_SAMPLETIME_480CYCLES
		},
		.usb_power_pin = {GPIOA, GPIO_PIN_8},
		.upper_ohms = 10000,
		.lower_ohms = 10000,
		.sample_interval_ms = 1000,
		.estimator = battery_estimator::config{
			.rate_period_ms = 300000
		}
	}};
	static node_controller controller{node_controller::config{
		.battery_sampling = battery_schedule::config{
			.update_interval_ms = 300000,
			.retry_interval_ms = 30000,
			.low_load_wait_ms = 60000
		},
		.battery_refresh_age_ms = 420000
	}, *application.measurements,
#ifndef NO_STORAGE
	    *application.records,
#endif
	    *application.indicator, *application.logger, application.gnss,
	    *application.journal, battery, *application.monitor, application.bluetooth};

	auto added = application.services.add(service_id::sensor, controller,
	    {service_id::logger, service_id::indicator,
#if TRACK_NODE_ENABLE_GNSS
	     service_id::gnss,
#endif
#ifndef NO_STORAGE
	     service_id::storage,
#endif
#if TRACK_NODE_ENABLE_LORA
	     service_id::radio,
#endif
#if TRACK_NODE_ENABLE_BLUETOOTH
	     service_id::bluetooth,
#endif
	    });

	if (!added)
	{
		return added;
	}
	if (auto bound = application.commands.bind(controller); !bound)
	{
		return bound;
	}

	application.telemetry.seal();

	return {};
}

//////////////////////////////////////////////////////////////////////////

status configure_low_power(firmware_composition &application)
{
	(void)application;
	(void)low_power::start();

	return {};
}

//////////////////////////////////////////////////////////////////////////

status configure_runtime(firmware_composition &application)
{
	if (!application.monitor || !application.indicator || !application.commands.bound() || application.runtime)
	{
		return fail(component::service, error_code::invalid_config);
	}

	static track_node runtime{application.devices, application.services, *application.monitor, *application.indicator};
	application.runtime = &runtime;

	return {};
}

//////////////////////////////////////////////////////////////////////////

int main()
{
	hardware::process_pending_requests();
	if (!initialize_platform())
	{
		panic();
	}

	static firmware_composition application;

	auto configured = configure_telemetry_journal(application)
	    .and_then([&]{ return configure_watchdog(application); })
	    .and_then([&]{ return configure_console(application); })
	    .and_then([&]{ return configure_sensors(application); })
	    .and_then([&]{ return configure_indicator(application); })
	    .and_then([&]{ return configure_gnss(application); })
	    .and_then([&]{ return configure_storage(application); })
	    .and_then([&]{ return configure_radio(application); })
	    .and_then([&]{ return configure_bluetooth(application); })
	    .and_then([&]{ return configure_control_button(application); })
	    .and_then([&]{ return configure_controller(application); })
	    .and_then([&]{ return configure_low_power(application); })
	    .and_then([&]{ return configure_runtime(application); });

	if (!configured)
	{
		panic();
	}

	if (auto started = application.runtime->init(); !started && !application.runtime->can_signal_error())
	{
		panic();
	}

	application.runtime->launch();
}
