Malibushko/TrackNode/src/application/node_controller.cpp

#include "application/node_controller.h"
#include "platform/hardware.h"
#include "common/common.h"
#ifndef NO_STORAGE
#include "application/log_record.h"
#endif

#include "infrastructure/indicator_service.h"
#include "infrastructure/gnss_service.h"
#include "infrastructure/logger_service.h"
#include "infrastructure/sensor_service.h"
#include "infrastructure/battery_service.h"
#include "application/battery_sink.h"
#ifndef NO_STORAGE
#include "infrastructure/storage_service.h"
#endif
#include "infrastructure/supervisor.h"
#include "platform/power_stats.h"

#include <charconv>
#include <cstdio>

namespace
{
constexpr std::size_t power_line_capacity = 88;
constexpr std::uint16_t first_irq_exception = 16;

struct power_rate_line
{
	std::array<char, power_line_capacity> text{};
	std::size_t length = 0;
};

//////////////////////////////////////////////////////////////////////////

bool append_power_rate(power_rate_line &line, const char *name, std::uint32_t count, std::uint32_t duration_ms)
{
	const auto tenths = rate_tenths_per_second(count, duration_ms);
	const auto available = line.text.size() - line.length;
	const auto written = std::snprintf(line.text.data() + line.length, available, " %s=%lu.%lu/s", name,
	                                   static_cast<unsigned long>(tenths / 10),
	                                   static_cast<unsigned long>(tenths % 10));
	const auto fits = written > 0 && static_cast<std::size_t>(written) < available;
	if (!fits)
	{
		line.text[line.length] = '\0';
		return false;
	}

	line.length += static_cast<std::size_t>(written);
	return true;
}

//////////////////////////////////////////////////////////////////////////

result<gnss_service::snapshot_t> read_gnss([[maybe_unused]] gnss_service *gnss)
{
#if TRACK_NODE_ENABLE_GNSS
	if (gnss)
	{
		return gnss->read();
	}
#endif
	return fail(component::service, error_code::not_initialized);
}

//////////////////////////////////////////////////////////////////////////

void name_wake_source(std::array<char, power_profile::name_capacity> &name, std::uint16_t exception)
{
	if (const auto *known = power_stats::exception_name(exception))
	{
		std::snprintf(name.data(), name.size(), "%s", known);
		return;
	}
	if (exception < first_irq_exception)
	{
		std::snprintf(name.data(), name.size(), "EXC%u", static_cast<unsigned>(exception));
		return;
	}

	std::snprintf(name.data(), name.size(), "IRQ%u", static_cast<unsigned>(exception - first_irq_exception));
}

//////////////////////////////////////////////////////////////////////////
}

node_controller::node_controller(config settings, sensor_service &sensor,
#ifndef NO_STORAGE
                                 storage_service &storage,
#endif
                                 indicator_service &indicator, logger_service &logger,
                                 gnss_service *gnss, telemetry_sink &telemetry,
                                 battery_service &battery, supervisor &monitor, battery_sink *battery_output)
    : config_(settings), sensor_(sensor),
#ifndef NO_STORAGE
      storage_(storage),
#endif
      indicator_(indicator),
      logger_(logger), gnss_(gnss), telemetry_(telemetry), battery_(battery), battery_output_(battery_output),
      battery_schedule_(settings.battery_sampling), monitor_(monitor)
{
}

//////////////////////////////////////////////////////////////////////////

status node_controller::start()
{
	if (inbox_)
	{
		return fail(component::rtos, error_code::already_initialized);
	}
	inbox_ = xQueueCreate(8, sizeof(command_request));
	if (!inbox_)
	{
		return fail(component::rtos, error_code::out_of_memory);
	}
	next_telemetry_id_ = telemetry_.next_sample_id();
	auto created = task_create(task_entry, "node", configMINIMAL_STACK_SIZE * 4,
	                           this, tskIDLE_PRIORITY + 1);
	if (!created)
	{
		vQueueDelete(inbox_);
		inbox_ = nullptr;
		return tl::make_unexpected(created.error());
	}
	task_ = *created;
	return {};
}

//////////////////////////////////////////////////////////////////////////

void node_controller::stop()
{
	if (task_)
	{
		vTaskDelete(task_);
		task_ = nullptr;
	}
	if (inbox_)
	{
		vQueueDelete(inbox_);
		inbox_ = nullptr;
	}
}

//////////////////////////////////////////////////////////////////////////

status node_controller::submit(command_request value)
{
	if (!inbox_)
	{
		return fail(component::rtos, error_code::not_initialized);
	}
	if (xQueueSend(inbox_, &value, 0) != pdPASS)
	{
		return fail(component::rtos, error_code::queue_full);
	}
	return {};
}

//////////////////////////////////////////////////////////////////////////

void node_controller::task_entry(void *argument)
{
	static_cast<node_controller *>(argument)->run();
}

//////////////////////////////////////////////////////////////////////////

void node_controller::run()
{
	take_sample();
	TickType_t last_sample_at = xTaskGetTickCount();

#if TRACK_NODE_TICKLESS_IDLE
	set_power_mode(power_mode::low);
#endif

	for (;;)
	{
		sample_battery();
		const TickType_t elapsed = xTaskGetTickCount() - last_sample_at;
		if (elapsed >= sample_period_)
		{
			take_sample();
			last_sample_at = xTaskGetTickCount();
			continue;
		}
		command_request received{};
		const TickType_t until_sample = sample_period_ - elapsed;
		if (xQueueReceive(inbox_, &received, next_wait(until_sample)) == pdPASS)
		{
			handle_command(received);
		}
		if (sensor_initialized_ && !sensor_faulted_)
		{
			monitor_.progress(service_id::sensor, xTaskGetTickCount());
		}
	}
}

//////////////////////////////////////////////////////////////////////////

void node_controller::sample_battery()
{
	const auto now_ms = common::ticks_to_ms(common::get_tick());
	const auto source_changed = battery_.poll_power();
	if (!source_changed)
	{
		return;
	}
	if (*source_changed)
	{
		battery_schedule_.request(now_ms);
	}
	battery_schedule_.poll(now_ms);
	const bool low_load = can_sample_battery(now_ms);
	if (!battery_.sampling() && battery_schedule_.ready(now_ms, low_load))
	{
		battery_.begin_series(now_ms, !low_load);
	}
	const bool was_sampling = battery_.sampling();
	if (was_sampling)
	{
		if (auto sampled = battery_.sample_step(now_ms, !low_load); !sampled)
		{
			(void)logger_.write("Battery sample failed: %u\r\n", static_cast<unsigned>(sampled.error().code));
		}
		if (!can_sample_battery(common::ticks_to_ms(common::get_tick())))
		{
			battery_.mark_loaded();
		}
		if (!battery_.sampling())
		{
			battery_schedule_.complete(now_ms, !battery_.needs_retry());
		}
	}
	battery_.set_pending(battery_schedule_.pending());
	const auto latest = battery_.current();
	if (!battery_output_ || published_battery_at_ == latest.revision)
	{
		return;
	}
	using namespace bluetooth_battery;
	const auto sent = battery_output_->submit_battery(snapshot{
		.flags = static_cast<std::uint8_t>((latest.reading_valid ? reading_valid : 0) |
		    (latest.usb_present ? usb_present : 0) | (latest.low_battery ? low_battery : 0) |
		    (latest.update_pending ? update_pending : 0) | (latest.unstable ? unstable : 0) |
		    (latest.reanchored ? estimate_adjusted : 0)),
		.level = latest.level_percent_estimate,
		.quality = latest.quality,
		.battery_mv = latest.battery_mv,
		.supply_mv = latest.supply_mv,
		.battery_raw = latest.battery_raw,
		.vrefint_raw = latest.vrefint_raw,
		.minimum_raw = latest.battery_min_raw,
		.maximum_raw = latest.battery_max_raw,
		.age_ms = latest.reading_valid ? now_ms - latest.sampled_at_ms : 0
	});
	if (sent)
	{
		published_battery_at_ = latest.revision;
	}
}

//////////////////////////////////////////////////////////////////////////

TickType_t node_controller::next_wait(TickType_t until_sample) const
{
	constexpr TickType_t heartbeat_period = pdMS_TO_TICKS(10000);
	const auto battery_series_running = battery_.sampling();
	const auto wake_limit = battery_series_running ? pdMS_TO_TICKS(battery_.sample_interval_ms()) : heartbeat_period;
	return until_sample < wake_limit ? until_sample : wake_limit;
}

//////////////////////////////////////////////////////////////////////////

bool node_controller::can_sample_battery(std::uint32_t now_ms) const
{
#ifndef NO_STORAGE
	return false;
#elif TRACK_NODE_ENABLE_GNSS
	return !gnss_ || !gnss_->is_high_power_active(now_ms);
#else
	(void)now_ms;
	return true;
#endif
}

//////////////////////////////////////////////////////////////////////////

status node_controller::init_sensor()
{
	auto started = sensor_.init();
	if (!started)
	{
		sensor_faulted_ = true;
		if (last_sample_)
		{
			last_sample_->valid = false;
		}
		monitor_.report(service_id::sensor, started.error(), service_health::degraded);
		(void)logger_.write("Sensor init failed: %u (HAL=%u, I2C=0x%lx)\r\n",
		                    static_cast<unsigned>(started.error().code),
		                    static_cast<unsigned>(started.error().hal_status),
		                    static_cast<unsigned long>(started.error().hal_detail));
		return started;
	}
	sensor_initialized_ = true;
	return {};
}

//////////////////////////////////////////////////////////////////////////
void node_controller::take_sample()
{
	if (sensor_faulted_)
	{
		return;
	}
	if (!sensor_initialized_ && !init_sensor())
	{
		return;
	}

	const auto measurement = sensor_.read();
	const TickType_t now = xTaskGetTickCount();
	if (measurement)
	{
		last_sample_ = sensor_sample{
		    .timestamp = now,
		    .sequence = next_sequence_++,
		    .temperature_c = measurement->temperature_c,
		    .pressure_pa = measurement->pressure_pa,
		    .valid = true,
		};
		monitor_.progress(service_id::sensor, now);

		std::optional<gnss_sample> gnss;
		if (const auto latest = read_gnss(gnss_))
		{
			gnss = gnss_sample{
			    .sequence = latest->sequence,
			    .received_at = latest->received_at,
			    .position = latest->position_valid
			                    ? std::optional<geo_position>{{latest->latitude, latest->longitude}}
			                    : std::nullopt,
			    .speed_mps = latest->speed_valid
			                     ? std::optional<float>{latest->speed_mps}
			                     : std::nullopt,
			    .utc_time = latest->time_valid
			                    ? std::optional<std::time_t>{latest->utc_time}
			                    : std::nullopt,
			};
		}

		const TickType_t recorded_at = xTaskGetTickCount();
		(void)telemetry_.submit(telemetry_sample{
			.sensor = *last_sample_,
			.gnss = gnss,
			.recorded_at = recorded_at,
			.id = next_telemetry_id_++
		});
#ifndef NO_STORAGE
		if (auto record = format_sample_csv(*last_sample_, gnss, recorded_at))
		{
			monitor_.set_health(service_id::sensor, service_health::ready);
#ifdef FAULT_INJECTION_ENABLE
		for (int i = 0; i < 3; i++)
#endif
			(void)storage_.submit_record(*record);
		}
		else
		{
			last_sample_->valid = false;
			monitor_.report(service_id::sensor, record.error(), service_health::degraded);
			(void)logger_.write("Sensor sample cannot be recorded\r\n");
		}
#else
		monitor_.set_health(service_id::sensor, service_health::ready);
#endif
	}
	else
	{
		sensor_faulted_ = true;
		if (last_sample_)
		{
			last_sample_->valid = false;
		}
		monitor_.report(service_id::sensor, measurement.error(), service_health::degraded);
		(void)logger_.write("Sensor read failed: %u (HAL=%u, I2C=0x%lx)\r\n",
		                    static_cast<unsigned>(measurement.error().code),
		                    static_cast<unsigned>(measurement.error().hal_status),
		                    static_cast<unsigned long>(measurement.error().hal_detail));
	}
}

//////////////////////////////////////////////////////////////////////////

status node_controller::reply(const char *format, ...)
{
	std::va_list arguments;
	va_start(arguments, format);
	auto accepted = write_command_reply(active_request_, logger_, format, arguments);
	va_end(arguments);
	return accepted;
}

//////////////////////////////////////////////////////////////////////////

void node_controller::handle_command(command_request request)
{
	if (request.reply_to && !request.reply_to->can_accept_session(request.session))
	{
		return;
	}
	active_request_ = request;
	const auto value = request.value;
	switch (value.type)
	{
		case command_type::ping:
			handle_ping();
			break;

		case command_type::bootload:
			handle_bootload();
			break;

		case command_type::read_temperature:
			handle_read_temperature();
			break;

		case command_type::read_pressure:
			handle_read_pressure();
			break;

		case command_type::read_gnss:
			handle_read_gnss();
			break;

		case command_type::read_log:
			handle_read_log();
			break;

		case command_type::set_sample_period:
			handle_set_sample_period(value.sample_period_ms);
			break;

		case command_type::reset_storage_prepare:
#ifdef NO_STORAGE
			(void)reply("ERR STORAGE_DISABLED\r\n");
#else
			(void)reply("WARNING ALL SD DATA WILL BE ERASED; SEND RESET STORAGE CONFIRM\r\n");
#endif
			break;

		case command_type::reset_storage_confirm:
			handle_reset_storage();
			break;

		case command_type::read_voltage:
			handle_read_voltage();
			break;

		case command_type::read_battery:
			handle_read_battery();
			break;

		case command_type::set_power_mode:
			handle_set_power_mode(value.power_mode_);
			break;

		case command_type::read_power:
			handle_read_power();
			break;
	}
}

//////////////////////////////////////////////////////////////////////////

void node_controller::handle_ping()
{
	if (auto accepted = indicator_.ping(); !accepted)
	{
		(void)reply("Indicator queue full\r\n");
		return;
	}

	(void)reply("PONG\r\n");
}

//////////////////////////////////////////////////////////////////////////

void node_controller::handle_bootload()
{
	hardware::request_bootloader();
}

//////////////////////////////////////////////////////////////////////////

bool node_controller::ensure_sample_available()
{
	if (!last_sample_)
	{
		(void)reply("Sensor sample unavailable (no measurement)\r\n");
		return false;
	}

	if (!last_sample_->valid)
	{
		const auto age = pdTICKS_TO_MS(xTaskGetTickCount() - last_sample_->timestamp);
		(void)reply("Sensor sample invalid (last age=%lu ms, seq=%lu)\r\n",
		                    static_cast<unsigned long>(age),
		                    static_cast<unsigned long>(last_sample_->sequence));
		return false;
	}
	return true;
}

//////////////////////////////////////////////////////////////////////////

void node_controller::set_power_mode(power_mode mode)
{
#if TRACK_NODE_ENABLE_GNSS
	if (gnss_)
	{
		gnss_->set_power_mode(mode);
	}
#endif
	telemetry_.set_power_mode(mode);
}

//////////////////////////////////////////////////////////////////////////

void node_controller::handle_read_temperature()
{
	if (!ensure_sample_available())
	{
		return;
	}

	const auto age = pdTICKS_TO_MS(xTaskGetTickCount() - last_sample_->timestamp);
	(void)reply("Temperature = %.2f C (age=%lu ms, seq=%lu)\r\n",
	                    static_cast<double>(last_sample_->temperature_c),
	                    static_cast<unsigned long>(age),
	                    static_cast<unsigned long>(last_sample_->sequence));
}

//////////////////////////////////////////////////////////////////////////

void node_controller::handle_read_pressure()
{
	if (!ensure_sample_available())
	{
		return;
	}

	const auto age = pdTICKS_TO_MS(xTaskGetTickCount() - last_sample_->timestamp);
	(void)reply("Pressure = %.2f Pa (age=%lu ms, seq=%lu)\r\n",
	                    static_cast<double>(last_sample_->pressure_pa),
	                    static_cast<unsigned long>(age),
	                    static_cast<unsigned long>(last_sample_->sequence));
}

//////////////////////////////////////////////////////////////////////////

void node_controller::handle_read_gnss()
{
#if TRACK_NODE_ENABLE_GNSS
	if (!gnss_)
	{
		(void)reply("ERR GNSS_DISABLED\r\n");
		return;
	}

	gnss_->request_lookup();
	const auto latest = gnss_->read();
	if (!latest)
	{
		(void)reply("GNSS snapshot unavailable\r\n");
		return;
	}

	char sequence[21]{};
	const auto converted = std::to_chars(sequence, sequence + sizeof(sequence) - 1,
	                                     latest->sequence);
	if (converted.ec != std::errc{})
	{
		(void)reply("ERR GNSS_FORMAT\r\n");
		return;
	}
	*converted.ptr = '\0';

	const auto age_ms = pdTICKS_TO_MS(xTaskGetTickCount() - latest->received_at);
	const bool fresh = age_ms <= gnss_freshness_limit_ms;
	const bool position_valid = fresh && latest->position_valid;
	const bool speed_valid = fresh && latest->speed_valid;
	const bool time_valid = fresh && latest->time_valid;
	(void)reply("GNSS seq=%s age=%lu ms pos=%u speed=%u time_field=%u\r\n",
	                    sequence, static_cast<unsigned long>(age_ms),
	                    static_cast<unsigned>(position_valid),
	                    static_cast<unsigned>(speed_valid),
	                    static_cast<unsigned>(time_valid));

	if (position_valid)
	{
		(void)reply("GNSS lat=%.6f lon=%.6f\r\n", latest->latitude, latest->longitude);
	}
	if (speed_valid)
	{
		(void)reply("GNSS speed=%.2f m/s\r\n", static_cast<double>(latest->speed_mps));
	}
	if (time_valid)
	{
		char utc_time[21]{};
		const auto time_converted = std::to_chars(utc_time, utc_time + sizeof(utc_time) - 1,
		                                        static_cast<std::int64_t>(latest->utc_time));
		if (time_converted.ec == std::errc{})
		{
			*time_converted.ptr = '\0';
			(void)reply("GNSS utc_unix_s=%s\r\n", utc_time);
		}
	}
#else
	(void)reply("ERR GNSS_DISABLED\r\n");
#endif
}

//////////////////////////////////////////////////////////////////////////

void node_controller::handle_read_log()
{
#ifdef NO_STORAGE
	(void)reply("ERR STORAGE_DISABLED\r\n");
#else
	const auto log = storage_.snapshot();
	if (log.health != service_health::ready)
	{
		(void)reply("Storage unavailable (dropped=%lu)\r\n",
		                    static_cast<unsigned long>(log.dropped_samples));
		return;
	}

	const auto age = pdTICKS_TO_MS(xTaskGetTickCount() - log.observed_at);
	char size_text[21]{};
	const auto converted = std::to_chars(size_text, size_text + sizeof(size_text) - 1,
	                                     log.log_size);
	if (converted.ec != std::errc{})
	{
		(void)reply("Log size unavailable\r\n");
		return;
	}
	*converted.ptr = '\0';
	(void)reply("Log %s: %s bytes (age=%lu ms, dropped=%lu)\r\n",
	                    log.file_name.data(), size_text,
	                    static_cast<unsigned long>(age),
	                    static_cast<unsigned long>(log.dropped_samples));
#endif
}

//////////////////////////////////////////////////////////////////////////

void node_controller::handle_set_sample_period(std::uint32_t period_ms)
{
	if (period_ms < 100 || period_ms > 60000)
	{
		(void)reply("ERR SAMPLE_PERIOD_RANGE 100..60000\r\n");
		return;
	}

	sample_period_ = pdMS_TO_TICKS(period_ms);
	(void)reply("OK SAMPLE_PERIOD %lu\r\n", static_cast<unsigned long>(period_ms));
}

//////////////////////////////////////////////////////////////////////////

void node_controller::handle_reset_storage()
{
#ifdef NO_STORAGE
	(void)reply("ERR STORAGE_DISABLED\r\n");
#else
	if (auto queued = storage_.request_format(); !queued)
	{
		(void)reply("ERR STORAGE_FORMAT_BUSY\r\n");
		return;
	}
	(void)reply("OK STORAGE_FORMAT_QUEUED\r\n");
#endif
}

//////////////////////////////////////////////////////////////////////////

void node_controller::handle_read_voltage()
{
	const auto latest = battery_.read();
	if (!latest)
	{
		(void)reply("ERR VOLTAGE_UNAVAILABLE\r\n");
		return;
	}
	const auto age_ms = common::ticks_to_ms(common::get_tick()) - latest->sampled_at_ms;
	(void)reply("supply_mv=%u low_voltage=%u vrefint_raw=%u age=%lu ms\r\n",
	                    static_cast<unsigned>(latest->supply_mv),
	                    static_cast<unsigned>(latest->low_supply),
	                    static_cast<unsigned>(latest->vrefint_raw),
	                    static_cast<unsigned long>(age_ms));
}

//////////////////////////////////////////////////////////////////////////

void node_controller::handle_read_battery()
{
	const auto now_ms = common::ticks_to_ms(common::get_tick());
	const auto latest = battery_.read();
	if (!latest)
	{
		battery_schedule_.request(now_ms);
		(void)reply("ERR BATTERY_UNAVAILABLE\r\n");
		return;
	}
	const auto age_ms = now_ms - latest->sampled_at_ms;
	if (age_ms >= config_.battery_refresh_age_ms)
	{
		battery_schedule_.request(now_ms);
	}
	(void)reply("battery_mv=%u level_percent_estimate=%u usb_present=%u low_battery=%u age=%lu ms\r\n",
	            static_cast<unsigned>(latest->battery_mv),
	            static_cast<unsigned>(latest->level_percent_estimate),
	            static_cast<unsigned>(latest->usb_present),
	            static_cast<unsigned>(latest->low_battery),
	            static_cast<unsigned long>(age_ms));
	(void)reply("supply_mv=%u battery_raw=%u vrefint_raw=%u min_raw=%u max_raw=%u q=%u\r\n",
	            static_cast<unsigned>(latest->supply_mv),
	            static_cast<unsigned>(latest->battery_raw),
	            static_cast<unsigned>(latest->vrefint_raw),
	            static_cast<unsigned>(latest->battery_min_raw),
	            static_cast<unsigned>(latest->battery_max_raw),
	            static_cast<unsigned>(latest->quality));
}

//////////////////////////////////////////////////////////////////////////

void node_controller::handle_set_power_mode(power_mode power_mode)
{
	set_power_mode(power_mode);
	(void)reply("power mode changed to: %s\r\n", power_mode == power_mode::high ? "high" : "low");
}

//////////////////////////////////////////////////////////////////////////

void node_controller::handle_read_power()
{
	if constexpr (!power_stats::enabled)
	{
		(void)reply("ERR POWER_STATS_DISABLED\r\n");
		return;
	}

	static power_report report{};
	power_stats::take_report(report);
	const auto &window = report.window;
	const auto awake = awake_permille(window.slept_cycles, window.duration_ms, report.core_clock_hz);
	const auto sleeps = rate_tenths_per_second(window.sleeps, window.duration_ms);
	const auto stops = rate_tenths_per_second(window.stops, window.duration_ms);
	(void)reply("POWER window_ms=%lu tickless=%u awake=%lu.%lu%% sleeps=%lu.%lu/s stops=%lu.%lu/s debug=%u\r\n",
	            static_cast<unsigned long>(window.duration_ms),
	            static_cast<unsigned>(report.tickless),
	            static_cast<unsigned long>(awake / 10),
	            static_cast<unsigned long>(awake % 10),
	            static_cast<unsigned long>(sleeps / 10),
	            static_cast<unsigned long>(sleeps % 10),
	            static_cast<unsigned long>(stops / 10),
	            static_cast<unsigned long>(stops % 10),
	            static_cast<unsigned>(report.debug_clocks_in_low_power));

	power_rate_line line{};
	const auto flush_line = [&](const char *label) {
		if (line.length != 0)
		{
			(void)reply("%s%s\r\n", label, line.text.data());
		}
		line = {};
	};
	const auto add_rate = [&](const char *label, const char *name, std::uint32_t count) {
		if (!append_power_rate(line, name, count, window.duration_ms))
		{
			flush_line(label);
			(void)append_power_rate(line, name, count, window.duration_ms);
		}
	};

	for (std::size_t index = 0; index < window.wake_source_count; ++index)
	{
		const auto &source = window.wake_sources[index];
		std::array<char, power_profile::name_capacity> name{};
		name_wake_source(name, source.exception);
		add_rate("WAKE", name.data(), source.count);
	}
	flush_line("WAKE");

	for (std::size_t index = 0; index < window.task_count; ++index)
	{
		const auto &task = window.tasks[index];
		add_rate("TASK", task.name.data(), task.switches);
	}
	if (window.untracked_switches != 0)
	{
		add_rate("TASK", "other", window.untracked_switches);
	}
	flush_line("TASK");
}

//////////////////////////////////////////////////////////////////////////
