Malibushko/TrackNode/include/application/node_controller.h

#pragma once

#include "application/command_sink.h"
#include "application/sample.h"
#include "application/telemetry_sink.h"
#include "application/battery_schedule.h"

#include <optional>

#include "common/power_mode.h"

class sensor_service;
class storage_service;
class indicator_service;
class logger_service;
class supervisor;
class gnss_service;
class battery_service;
class battery_sink;

// The application workflow: sampling cadence, command meaning and data flow.
class node_controller final : public command_sink
{
public:
	struct config
	{
		battery_schedule::config battery_sampling{};
		std::uint32_t battery_refresh_age_ms = 420000;
	};

	node_controller(config settings, sensor_service &sensor,
#ifndef NO_STORAGE
	                storage_service &storage,
#endif
	                indicator_service &indicator, logger_service &logger,
	                gnss_service *gnss, telemetry_sink &telemetry,
	                battery_service &battery, supervisor &monitor, battery_sink *battery_output = nullptr);

public: // Common lifecycle
	status start();
	void stop();

public: // Application API
	using command_sink::submit;
	status submit(command_request request) override;

private: // Common task loop
	static void task_entry(void *argument);
	void run();
	status init_sensor();

private: // Application behavior
	void take_sample();
	void sample_battery();
	[[nodiscard]] TickType_t next_wait(TickType_t until_sample) const;
	bool can_sample_battery(std::uint32_t now_ms) const;
	void handle_command(command_request request);
	status reply(const char *format, ...);
	void handle_ping();
	void handle_bootload();
	void handle_read_temperature();
	void handle_read_pressure();
	void handle_read_gnss();
	void handle_read_log();
	void handle_set_sample_period(std::uint32_t period_ms);
	void handle_reset_storage();
	void handle_read_voltage();
	void handle_read_battery();
	void handle_set_power_mode(power_mode power_mode);
	void handle_read_power();
	bool ensure_sample_available();

	void set_power_mode(power_mode power_mode);

private: // State
	config config_;
	sensor_service &sensor_;
#ifndef NO_STORAGE
	storage_service &storage_;
#endif
	indicator_service &indicator_;
	logger_service &logger_;
	gnss_service *gnss_;
	telemetry_sink &telemetry_;
	battery_service &battery_;
	battery_sink *battery_output_;
	std::optional<std::uint32_t> published_battery_at_;
	battery_schedule battery_schedule_;
	supervisor &monitor_;
	QueueHandle_t inbox_ = nullptr;
	TaskHandle_t task_ = nullptr;
	std::optional<sensor_sample> last_sample_;
	command_request active_request_{};
	std::uint32_t next_sequence_ = 1;
	sequence_t next_telemetry_id_ = 1;
	TickType_t sample_period_ = pdMS_TO_TICKS(15000);
	bool sensor_initialized_ = false;
	bool sensor_faulted_ = false;
};
