Malibushko/TrackNode/src/infrastructure/bluetooth_service.cpp

#include "infrastructure/bluetooth_service.h"
#include "infrastructure/command_parser.h"
#include "infrastructure/logger_service.h"
#include "infrastructure/supervisor.h"
#include "application/log_record.h"
#include "infrastructure/bluetooth_telemetry.h"
#include <algorithm>
#include <cstring>
#include <cstdio>
#include <type_traits>

static_assert(std::is_trivially_copyable_v<telemetry_sample>);

status bluetooth_service::start()
{
	const auto already_started = task_ || replies_ || samples_ || batteries_ || logs_;
	if (already_started)
	{
		return fail(component::rtos, error_code::already_initialized);
	}
	if (auto validated = validate_config(); !validated)
	{
		return validated;
	}

	replies_ = xQueueCreate(config_.reply_queue_capacity, sizeof(command_reply));
	samples_ = xQueueCreate(1, sizeof(telemetry_sample));
	batteries_ = xQueueCreate(1, sizeof(queued_battery));
	logs_ = xQueueCreate(config_.log_queue_capacity, sizeof(log_message));
	const auto queue_allocation_failed = !replies_ || !samples_ || !batteries_ || !logs_;
	if (queue_allocation_failed)
	{
		stop();
		return fail(component::rtos, error_code::out_of_memory);
	}

	const auto created = task_create(task_entry, "bluetooth", config_.task_stack_depth, this, config_.task_priority);
	if (!created)
	{
		stop();
		return tl::unexpected(created.error());
	}

	task_ = *created;
	logger_.set_log_sink(this);
	monitor_.set_health(service_id::bluetooth, service_health::starting);
	return {};
}

//////////////////////////////////////////////////////////////////////////

void bluetooth_service::stop()
{
	logger_.set_log_sink(nullptr);
	log_session_.store(0);
	if (task_)
	{
		vTaskDelete(task_);
		task_ = nullptr;
	}
	if (journal_)
	{
		journal_->reset_history_transfer();
	}
	if (replies_)
	{
		vQueueDelete(replies_);
		replies_ = nullptr;
	}
	if (samples_)
	{
		vQueueDelete(samples_);
		samples_ = nullptr;
	}
	if (logs_)
	{
		vQueueDelete(logs_);
		logs_ = nullptr;
	}
	if (batteries_)
	{
		vQueueDelete(batteries_);
		batteries_ = nullptr;
	}

	reset_session();
	pairing_window_requested_.store(false);
	blocked_session_ = 0;
	if (indicator_)
	{
		indicator_->set_pairing(false);
	}
	backend_.stop();
	latest_sample_.reset();
	measurement_pending_ = false;
	latest_battery_.reset();
	battery_pending_ = false;
	link_ = {};
	advertise_pending_ = false;
}

//////////////////////////////////////////////////////////////////////////

status bluetooth_service::validate_config() const
{
	const auto invalid_timing = config_.poll_timeout_ms == 0 || config_.idle_timeout_ms == 0 || config_.measurement_lifetime_ms == 0 ||
		pdMS_TO_TICKS(config_.reconnect_interval_ms) == 0;
	const auto invalid_command_capacity = config_.command_capacity == 0 ||
		config_.command_capacity > bluetooth_event{}.payload.size();
	const auto invalid_queue_capacity = config_.reply_queue_capacity == 0 || config_.log_queue_capacity == 0 ||
		config_.reply_queue_capacity > UINT32_MAX || config_.log_queue_capacity > UINT32_MAX;
	const auto output_processing_disabled = config_.replies_per_cycle == 0 || config_.logs_per_cycle == 0;
	const auto invalid_log_text_capacity = config_.log_text_capacity == 0 ||
		config_.log_text_capacity >= bluetooth_config::log_text_storage_capacity;
	const auto invalid_task_config = config_.task_stack_depth == 0 || config_.task_priority >= configMAX_PRIORITIES;
	if (invalid_timing || invalid_command_capacity || invalid_queue_capacity ||
		output_processing_disabled || invalid_log_text_capacity || invalid_task_config)
	{
		return fail(component::service, error_code::invalid_config);
	}
	return {};
}

//////////////////////////////////////////////////////////////////////////

bool bluetooth_service::initialize_backend()
{
	measurement_pending_ = latest_sample_.has_value();
	battery_pending_ = latest_battery_.has_value();
	reset_exchange();
	link_ = {};
	advertise_pending_ = false;
	const auto initialized = backend_.init();
	if (!initialized)
	{
		monitor_.report(service_id::bluetooth, initialized.error(), service_health::degraded);
		(void)logger_.write("BLE bridge init failed: %u\r\n", static_cast<unsigned>(initialized.error().code));
		monitor_.progress(service_id::bluetooth, xTaskGetTickCount());
		vTaskDelay(pdMS_TO_TICKS(config_.reconnect_interval_ms));
		return false;
	}

	monitor_.set_health(service_id::bluetooth, service_health::ready);
	return true;
}


//////////////////////////////////////////////////////////////////////////

status bluetooth_service::on_pairing_mode_requested()
{
	if (!task_)
	{
		return fail(component::service, error_code::not_initialized);
	}
	reset_session();
	pairing_window_requested_.store(true);
	wake_task();
	return {};
}


//////////////////////////////////////////////////////////////////////////

status bluetooth_service::on_advertising_requested()
{
	if (!task_)
	{
		return fail(component::service, error_code::not_initialized);
	}
	advertising_requested_.store(true);
	wake_task();
	return {};
}

//////////////////////////////////////////////////////////////////////////

bool bluetooth_service::can_accept_session(std::uint32_t session) const
{
	return !pairing_window_requested_.load() && session != 0 && session == command_session_.load();
}

//////////////////////////////////////////////////////////////////////////

status bluetooth_service::submit(const telemetry_sample &sample)
{
	if (!samples_)
	{
		return fail(component::service, error_code::not_initialized);
	}
	const auto queued = from_freertos(xQueueOverwrite(samples_, &sample));
	wake_task();
	return queued;
}

//////////////////////////////////////////////////////////////////////////

status bluetooth_service::submit_battery(const bluetooth_battery::snapshot &value)
{
	if (!batteries_)
	{
		return fail(component::service, error_code::not_initialized);
	}
	if (!bluetooth_battery::valid(value))
	{
		return fail(component::service, error_code::invalid_argument);
	}
	const queued_battery queued{
		.value = value,
		.received_at = xTaskGetTickCount()
	};
	const auto accepted = from_freertos(xQueueOverwrite(batteries_, &queued));
	wake_task();
	return accepted;
}

//////////////////////////////////////////////////////////////////////////

status bluetooth_service::submit_reply(const command_reply &reply)
{
	if (!replies_)
	{
		return fail(component::service, error_code::not_initialized);
	}
	if (xQueueSend(replies_, &reply, 0) != pdPASS)
	{
		return fail(component::service, error_code::queue_full);
	}

	wake_task();
	return {};
}

//////////////////////////////////////////////////////////////////////////

void bluetooth_service::submit_log(std::string_view text)
{
	const auto session = log_session_.load();
	const auto log_stream_unavailable = session == 0 || !logs_;
	if (log_stream_unavailable)
	{
		return;
	}

	log_message message{
		.session = session,
		.timestamp_ms = pdTICKS_TO_MS(xTaskGetTickCount()),
		.text = {}
	};
	std::size_t index = 0;
	for (const char value : text)
	{
		if (index == config_.log_text_capacity)
		{
			break;
		}
		message.text[index++] = value == '\r' || value == '\n' ? ' ' : value;
	}
	if (xQueueSend(logs_, &message, 0) != pdPASS)
	{
		dropped_logs_.fetch_add(1);
	}
	wake_task();
}

//////////////////////////////////////////////////////////////////////////

void bluetooth_service::set_power_mode(power_mode)
{
	// Intentional no-op: Zephyr manages CPU sleep automatically.
}


//////////////////////////////////////////////////////////////////////////

void bluetooth_service::task_entry(void *argument)
{
	static_cast<bluetooth_service *>(argument)->run();
}

//////////////////////////////////////////////////////////////////////////

void bluetooth_service::run()
{
	bool ready = false;
	for (;;)
	{
		if (!ready)
		{
			ready = initialize_backend();
			if (!ready)
			{
				continue;
			}
		}

		bool poll_failed = false;
		const auto outcome = poll_and_process(poll_failed);
		if (!outcome)
		{
			ready = handle_failure(outcome.error(), poll_failed);
		}
		else
		{
			monitor_.set_health(service_id::bluetooth, service_health::ready);
		}

		monitor_.progress(service_id::bluetooth, xTaskGetTickCount());
	}
}

//////////////////////////////////////////////////////////////////////////

status bluetooth_service::poll_and_process(bool &poll_failed)
{
	if (const auto controlled = process_pairing_request(); !controlled)
	{
		return controlled;
	}

	const auto event = backend_.poll(has_pending_work() ? config_.poll_timeout_ms : config_.idle_timeout_ms);
	poll_failed = !event.has_value();
	if (!event)
	{
		return tl::unexpected(event.error());
	}

	return handle_event(*event)
		.and_then([&]{ return process_advertising(); })
		.and_then([&]{ return process_output(); });
}


//////////////////////////////////////////////////////////////////////////

bool bluetooth_service::has_pending_work() const
{
	const auto output_queued = uxQueueMessagesWaiting(replies_) != 0 || uxQueueMessagesWaiting(samples_) != 0 ||
		uxQueueMessagesWaiting(batteries_) != 0;
	const auto cached_output_waits_for_retry = measurement_pending_ || battery_pending_ || advertise_pending_;
	const auto log_stream_active = log_session_.load() != 0;
	const auto history_transfer_active = journal_ && journal_->history_response_pending();
	return output_queued || cached_output_waits_for_retry || log_stream_active || history_transfer_active ||
		pairing_window_requested_.load() || advertising_requested_.load();
}

//////////////////////////////////////////////////////////////////////////

void bluetooth_service::wake_task()
{
	signal_task_event(task_);
}

//////////////////////////////////////////////////////////////////////////

status bluetooth_service::process_pairing_request()
{
	if (!pairing_window_requested_.exchange(false))
	{
		return {};
	}
	reset_exchange();
	blocked_session_ = link_.session;
	link_ = {};
	return backend_.open_pairing_window();
}

//////////////////////////////////////////////////////////////////////////

status bluetooth_service::process_advertising()
{
	if (advertising_requested_.exchange(false))
	{
		advertise_pending_ = true;
	}
	if (!advertise_pending_)
	{
		return {};
	}

	const auto outcome = backend_.start_advertise();
	advertise_pending_ = !outcome.has_value();
	return outcome;
}

//////////////////////////////////////////////////////////////////////////

status bluetooth_service::process_output()
{
	return process_replies()
		.and_then([&]{ return process_sample(); })
		.and_then([&]{ return process_battery(); })
		.and_then([&]{ return process_history(); })
		.and_then([&]{ return process_logs(); });
}

//////////////////////////////////////////////////////////////////////////

status bluetooth_service::process_replies()
{
	command_reply reply{};
	for (std::size_t index = 0; index < config_.replies_per_cycle && xQueueReceive(replies_, &reply, 0) == pdPASS; ++index)
	{
		if (const auto sent = send_reply(reply); !sent)
		{
			return sent;
		}
	}

	return {};
}

//////////////////////////////////////////////////////////////////////////

status bluetooth_service::process_battery()
{
	queued_battery queued{};
	if (xQueueReceive(batteries_, &queued, 0) == pdPASS)
	{
		latest_battery_ = queued;
		battery_pending_ = true;
	}
	if (!battery_pending_ || !latest_battery_)
	{
		return {};
	}
	const auto elapsed = static_cast<std::uint32_t>(
	    (xTaskGetTickCount() - latest_battery_->received_at) * portTICK_PERIOD_MS);
	const auto value = bluetooth_battery::aged(latest_battery_->value, elapsed);
	const auto bytes = bluetooth_battery::encode(value);
	if (auto sent = backend_.publish_battery(bytes); !sent)
	{
		return sent;
	}
	battery_pending_ = false;
	return {};
}

//////////////////////////////////////////////////////////////////////////

status bluetooth_service::process_sample()
{
	telemetry_sample sample{};
	const bool received = xQueueReceive(samples_, &sample, 0) == pdPASS;
	if (received)
	{
		latest_sample_ = sample;
		measurement_pending_ = true;
	}
	const auto cached_measurement_needs_publication = measurement_pending_ && latest_sample_;
	if (cached_measurement_needs_publication)
	{
		const auto value = format_bluetooth_measurement(*latest_sample_, xTaskGetTickCount(), config_.measurement_lifetime_ms);
		const auto bytes = bluetooth_measurement::encode(value);
		if (const auto sent = backend_.publish_measurement(bytes); !sent)
		{
			return sent;
		}
		measurement_pending_ = false;
	}
	const auto sample_not_ready_for_telemetry_stream = !received || !sample.sensor.valid || !link_.connected || !link_.subscribed;
	if (sample_not_ready_for_telemetry_stream)
	{
		return {};
	}

	const auto record = format_sample_csv(sample.sensor, sample.gnss, sample.recorded_at);
	if (!record)
	{
		return tl::unexpected(record.error());
	}

	std::array<char, log_record{}.text.size() + 2> text{};
	text[0] = 'T';
	text[1] = ',';
	std::copy_n(record->text.begin(), record->length, text.begin() + 2);
	return send_text({text.data(), static_cast<std::size_t>(record->length) + 2}, link_.session);
}

//////////////////////////////////////////////////////////////////////////

status bluetooth_service::process_history()
{
	if (!journal_)
	{
		return {};
	}
	const auto line = journal_->next_history_response();
	if (line.empty())
	{
		return {};
	}
	const auto sent = send_text(line, link_.session);
	if (sent)
	{
		journal_->on_history_response_sent();
	}
	return sent;
}

//////////////////////////////////////////////////////////////////////////

status bluetooth_service::process_logs()
{
	const auto session = log_session_.load();
	log_message message{};
	if (session == 0)
	{
		while (xQueueReceive(logs_, &message, 0) == pdPASS)
		{
		}
		return {};
	}

	const auto dropped = dropped_logs_.exchange(0);
	if (dropped != 0)
	{
		std::array<char, bluetooth_config::log_line_storage_capacity> text{};
		std::snprintf(text.data(), text.size(), "[dropped %lu BLE log messages]", static_cast<unsigned long>(dropped));
		if (auto sent = send_log_line(pdTICKS_TO_MS(xTaskGetTickCount()), text.data(), session); !sent)
		{
			dropped_logs_.fetch_add(dropped);
			return sent;
		}
	}
	for (std::size_t index = 0; index < config_.logs_per_cycle; ++index)
	{
		const auto diagnostic = process_diagnostic(session);
		if (!diagnostic)
		{
			return tl::unexpected(diagnostic.error());
		}
		if (*diagnostic)
		{
			continue;
		}
		if (xQueueReceive(logs_, &message, 0) != pdPASS)
		{
			break;
		}
		if (message.session != session)
		{
			continue;
		}
		if (auto sent = send_log_line(message.timestamp_ms, message.text.data(), session); !sent)
		{
			dropped_logs_.fetch_add(1);
			return sent;
		}
	}
	return {};
}

//////////////////////////////////////////////////////////////////////////

result<bool> bluetooth_service::process_diagnostic(std::uint32_t session)
{
	const auto record = diagnostics_.next(monitor_);
	if (!record)
	{
		return false;
	}
	std::array<char, bluetooth_config::log_text_storage_capacity> text{};
	const auto sent = format_diagnostic(*record, text)
		.and_then([&]{ return send_log_line(pdTICKS_TO_MS(xTaskGetTickCount()), text.data(), session); });
	if (!sent)
	{
		return tl::unexpected(sent.error());
	}
	diagnostics_.accept(*record);
	return true;
}


//////////////////////////////////////////////////////////////////////////

status bluetooth_service::handle_event(const bluetooth_event &event)
{
	switch (event.type)
	{
		case bluetooth_event::kind::link_changed:
			return handle_link_changed(event.link);
		case bluetooth_event::kind::pairing_changed:
			return handle_pairing_changed(event.pairing);
		case bluetooth_event::kind::received:
			return handle_received(event);
		default:
			return {};
	}
}

//////////////////////////////////////////////////////////////////////////

status bluetooth_service::handle_link_changed(const bluetooth_link &link)
{
	const auto is_blocked_connection = link.connected && link.session != 0 && link.session == blocked_session_;
	if (is_blocked_connection)
	{
		return {};
	}

	const auto session_changed = link.session != link_.session;
	if (session_changed)
	{
		measurement_pending_ = latest_sample_.has_value();
		battery_pending_ = latest_battery_.has_value();
	}

	const auto exchange_unavailable = !link.connected || !link.subscribed;
	if (session_changed || exchange_unavailable)
	{
		reset_exchange();
	}

	link_ = link;
	const auto can_accept_commands = link.connected && !pairing_window_requested_.load();
	command_session_.store(can_accept_commands ? link.session : 0);
	advertise_pending_ = !link_.connected;
	return {};
}

//////////////////////////////////////////////////////////////////////////

status bluetooth_service::handle_pairing_changed(bool active)
{
	if (indicator_)
	{
		indicator_->set_pairing(active);
	}
	(void)logger_.write(active ? "BLE pairing window opened\r\n" : "BLE pairing window closed\r\n");
	return {};
}

//////////////////////////////////////////////////////////////////////////

status bluetooth_service::handle_received(const bluetooth_event &event)
{
	const auto command_from_inactive_session = !can_accept_session(event.link.session) || !link_.connected || event.link.session != link_.session;
	if (command_from_inactive_session)
	{
		return {};
	}

	if (++request_id_ == 0)
	{
		++request_id_;
	}
	if (event.size > event.payload.size())
	{
		return fail(component::service, error_code::invalid_argument);
	}

	std::string_view text{reinterpret_cast<const char *>(event.payload.data()), event.size};
	while (!text.empty() && (text.back() == '\r' || text.back() == '\n'))
	{
		text.remove_suffix(1);
	}
	if (text.size() > config_.command_capacity)
	{
		return send_error("ERR LINE_TOO_LONG\r\n", event.link.session);
	}
	const auto invalid_command_line = text.empty() || text.find_first_of(std::string_view{"\0\r\n", 3}) != std::string_view::npos;
	if (invalid_command_line)
	{
		return send_error("ERR INVALID_SYNTAX\r\n", event.link.session);
	}

	return handle_command(text, event.link.session);
}

//////////////////////////////////////////////////////////////////////////

status bluetooth_service::handle_command(std::string_view text, std::uint32_t session)
{
	if (journal_ && journal_->can_handle_command(text))
	{
		const auto response = journal_->handle_history_command(text, session);
		return response.empty() ? status{} : send_text(response, session);
	}

	const auto log_stream_command = text == "SET LOG_STREAM ON" || text == "SET LOG_STREAM OFF";
	if (log_stream_command)
	{
		return handle_log_stream(text == "SET LOG_STREAM ON", session);
	}
	const auto parsed = parse_command(text);
	if (!parsed)
	{
		return send_parse_error(parsed.error(), session);
	}

	const auto accepted = commands_.submit(command_request{
		.value = *parsed,
		.reply_to = this,
		.request_id = request_id_,
		.session = session
	});
	if (!accepted)
	{
		return send_error("ERR COMMAND_QUEUE_FULL\r\n", session);
	}

	return {};
}

//////////////////////////////////////////////////////////////////////////

status bluetooth_service::handle_log_stream(bool enabled, std::uint32_t session)
{
	reset_log_stream();
	diagnostics_.reset();
	log_message discarded{};
	while (xQueueReceive(logs_, &discarded, 0) == pdPASS)
	{
	}
	const auto can_enable_log_stream = enabled && link_.subscribed;
	if (can_enable_log_stream)
	{
		log_session_.store(session);
		(void)logger_.write("BLE firmware log stream enabled\r\n");
	}
	return send_error(enabled ? "OK LOG_STREAM ON\r\n" : "OK LOG_STREAM OFF\r\n", session);
}

//////////////////////////////////////////////////////////////////////////

bool bluetooth_service::handle_failure(error failure, bool poll_failed)
{
	monitor_.report(service_id::bluetooth, failure, service_health::degraded);
	(void)logger_.write("BLE bridge failed: %u\r\n", static_cast<unsigned>(failure.code));
	const auto transient_output_failure = failure.code == error_code::not_ready || failure.code == error_code::queue_full;
	const auto backend_recovery_required = poll_failed || !transient_output_failure;
	if (backend_recovery_required)
	{
		reset_exchange();
		link_ = {};
		reset_session();
		if (indicator_)
		{
			indicator_->set_pairing(false);
		}
		backend_.stop();
		return false;
	}

	return true;
}


//////////////////////////////////////////////////////////////////////////

status bluetooth_service::send_reply(const command_reply &reply)
{
	const auto reply_from_inactive_exchange = !can_accept_session(reply.session) || !link_.connected || !link_.subscribed || reply.session != link_.session;
	if (reply_from_inactive_exchange)
	{
		return {};
	}

	const auto end = std::find(reply.text.begin(), reply.text.end(), '\0');
	if (end == reply.text.end())
	{
		return fail(component::service, error_code::invalid_argument);
	}

	return send_text({reply.text.data(), static_cast<std::size_t>(end - reply.text.begin())}, reply.session);
}

//////////////////////////////////////////////////////////////////////////

status bluetooth_service::send_text(std::string_view text, std::uint32_t session)
{
	const auto notification_channel_unavailable = !link_.connected || !link_.subscribed || link_.session != session || link_.max_payload == 0;
	if (notification_channel_unavailable)
	{
		return fail(component::service, error_code::not_ready);
	}

	while (!text.empty())
	{
		if (!can_accept_session(session))
		{
			return fail(component::service, error_code::not_ready);
		}
		const auto size = std::min<std::size_t>(text.size(), link_.max_payload);
		const auto sent = backend_.send({reinterpret_cast<const std::uint8_t *>(text.data()), size}, session);
		if (!sent)
		{
			return sent;
		}

		text.remove_prefix(size);
		monitor_.progress(service_id::bluetooth, xTaskGetTickCount());
	}

	return {};
}

//////////////////////////////////////////////////////////////////////////

status bluetooth_service::send_error(const char *text, std::uint32_t session)
{
	command_reply reply{
		.request_id = request_id_,
		.session = session
	};
	const auto size = std::strlen(text);
	if (size >= reply.text.size())
	{
		return fail(component::service, error_code::invalid_argument);
	}

	std::copy_n(text, size, reply.text.begin());
	return submit_reply(reply);
}

//////////////////////////////////////////////////////////////////////////

status bluetooth_service::send_parse_error(command_parse_error code, std::uint32_t session)
{
	switch (code)
	{
		case command_parse_error::unknown_command:
			return send_error("ERR UNKNOWN_COMMAND\r\n", session);
		case command_parse_error::invalid_number:
			return send_error("ERR INVALID_NUMBER\r\n", session);
		default:
			return send_error("ERR INVALID_SYNTAX\r\n", session);
	}
}

//////////////////////////////////////////////////////////////////////////

status bluetooth_service::send_log_line(std::uint32_t timestamp_ms, const char *text, std::uint32_t session)
{
	std::array<char, bluetooth_config::log_line_storage_capacity> line{};
	const int length = std::snprintf(line.data(), line.size(), "L,%lu,%s\r\n",
		static_cast<unsigned long>(timestamp_ms), text);
	if (length < 0 || static_cast<std::size_t>(length) >= line.size())
	{
		return fail(component::service, error_code::invalid_argument);
	}
	return send_text({line.data(), static_cast<std::size_t>(length)}, session);
}


//////////////////////////////////////////////////////////////////////////

void bluetooth_service::reset_exchange()
{
	if (journal_)
	{
		journal_->reset_history_transfer();
	}
	reset_session();
	reset_log_stream();
	xQueueReset(replies_);
	xQueueReset(logs_);
}

//////////////////////////////////////////////////////////////////////////

void bluetooth_service::reset_session()
{
	command_session_.store(0);
}

//////////////////////////////////////////////////////////////////////////

void bluetooth_service::reset_log_stream()
{
	log_session_.store(0);
	dropped_logs_.store(0);
}
