Malibushko/TrackNode/include/clock.h

#pragma once
#include "hal.h"
#include "error.h"

TIM_HandleTypeDef htim2;

extern "C" void SysTick_Handler()
{
    HAL_IncTick();
}

void SystemClock_Config()
{
    RCC_OscInitTypeDef RCC_OscInitStruct = {0};
    RCC_ClkInitTypeDef RCC_ClkInitStruct = {0};

    __HAL_RCC_PWR_CLK_ENABLE();
    __HAL_PWR_VOLTAGESCALING_CONFIG(PWR_REGULATOR_VOLTAGE_SCALE1);

    RCC_OscInitStruct.OscillatorType = RCC_OSCILLATORTYPE_HSE;
    RCC_OscInitStruct.HSEState       = RCC_HSE_ON;
    RCC_OscInitStruct.PLL.PLLState   = RCC_PLL_ON;
    RCC_OscInitStruct.PLL.PLLSource  = RCC_PLLSOURCE_HSE;
    RCC_OscInitStruct.PLL.PLLM       = 25;
    RCC_OscInitStruct.PLL.PLLN       = 288;
    RCC_OscInitStruct.PLL.PLLP       = RCC_PLLP_DIV4;
    RCC_OscInitStruct.PLL.PLLQ       = 6;

    if (HAL_RCC_OscConfig(&RCC_OscInitStruct) != HAL_OK)
    {
        Error_Handler();
    }

    RCC_ClkInitStruct.ClockType = RCC_CLOCKTYPE_SYSCLK | RCC_CLOCKTYPE_HCLK |
                                  RCC_CLOCKTYPE_PCLK1 | RCC_CLOCKTYPE_PCLK2;
    RCC_ClkInitStruct.SYSCLKSource   = RCC_SYSCLKSOURCE_PLLCLK;
    RCC_ClkInitStruct.AHBCLKDivider  = RCC_SYSCLK_DIV1;  // HCLK = 72 MHz
    RCC_ClkInitStruct.APB1CLKDivider = RCC_HCLK_DIV2;    // PCLK1 = 36 MHz
    RCC_ClkInitStruct.APB2CLKDivider = RCC_HCLK_DIV1;    // PCLK2 = 72 MHz

    if (HAL_RCC_ClockConfig(&RCC_ClkInitStruct, FLASH_LATENCY_2) != HAL_OK)
    {
        Error_Handler();
    }
}

static void PWM_Init()
{
    __HAL_RCC_TIM2_CLK_ENABLE();

    htim2.Instance = TIM2;
    htim2.Init.Prescaler         = 71;    // 72Mhz / 72 = 1 MHz
    htim2.Init.CounterMode       = TIM_COUNTERMODE_UP;
    htim2.Init.Period            = 999;   // f_PWM = 1 kHz
    htim2.Init.ClockDivision     = TIM_CLOCKDIVISION_DIV1;
    htim2.Init.AutoReloadPreload = TIM_AUTORELOAD_PRELOAD_ENABLE;

    if (HAL_TIM_PWM_Init(&htim2) != HAL_OK)
    {
        Error_Handler();
    }

    TIM_OC_InitTypeDef sConfigOC = {0};
    sConfigOC.OCMode     = TIM_OCMODE_PWM1;
    sConfigOC.Pulse      = 0;
    sConfigOC.OCPolarity = TIM_OCPOLARITY_HIGH;
    sConfigOC.OCFastMode = TIM_OCFAST_DISABLE;

    if (HAL_TIM_PWM_ConfigChannel(&htim2, &sConfigOC, TIM_CHANNEL_2) != HAL_OK)
    {
        Error_Handler();
    }

    HAL_TIM_PWM_Start(&htim2, TIM_CHANNEL_2);
}

void InitClock()
{
    SystemClock_Config();
    PWM_Init();
}
