Malibushko/TrackNode/src/hal/gpio.h

#pragma once
#include "hal.h"

void InitGPIO()
{
    __HAL_RCC_GPIOA_CLK_ENABLE();
    GPIO_InitTypeDef GPIO_InitStruct{};

    GPIO_InitStruct.Pin = GPIO_PIN_9;
    GPIO_InitStruct.Mode = GPIO_MODE_AF_PP;
    GPIO_InitStruct.Pull = GPIO_NOPULL;
    GPIO_InitStruct.Speed = GPIO_SPEED_FREQ_HIGH;
    GPIO_InitStruct.Alternate = GPIO_AF7_USART1;

    HAL_GPIO_Init(GPIOA, &GPIO_InitStruct);
}
