Malibushko/TrackNode/firmware/bluetooth/test/bridge_service_test.cpp

#include "infrastructure/bridge_service.h"
#include "drivers/uart.h"
#include "drivers/bluetooth_backend.h"
#include <algorithm>
#include <deque>
#include <iostream>
#include <stdexcept>
#include <vector>

std::uint32_t now_ms = 0;

void require(bool condition)
{
	if (!condition)
	{
		throw std::runtime_error("Bridge service test failed");
	}
}

class fake_uart final : public ble::uart
{
public:
	std::deque<std::vector<std::uint8_t>> chunks;
	bool io_error = false;
	bool running = false;
	std::deque<ble_bridge::frame> written;
	ble_bridge::bridge_codec codec;

	ble::status init() override
	{
		running = true;
		return {};
	}

	void stop() override
	{
		running = false;
	}

	ble::status write(ble::data_view data, std::uint32_t) override
	{
		if (data.size == 1 && data.data[0] == 0)
		{
			return {};
		}
		written.push_back(codec.decode({data.data, data.size}).value());
		return {};
	}

	ble::result<std::size_t> read(ble::mutable_data_view output, std::uint32_t) override
	{
		if (io_error)
		{
			io_error = false;
			return ble::fail(ble::component::uart, ble::error_code::io);
		}

		if (chunks.empty())
		{
			return ble::fail(ble::component::uart, ble::error_code::timeout);
		}

		auto &chunk = chunks.front();
		const auto size = std::min(output.capacity, chunk.size());
		std::copy_n(chunk.begin(), size, output.data);
		chunk.erase(chunk.begin(), chunk.begin() + size);
		if (chunk.empty())
		{
			chunks.pop_front();
		}

		return size;
	}
};

class fake_bluetooth final : public ble::bluetooth_backend
{
public:
	bool pairing = false;
	ble::status open_pairing_window() override { pairing = true; return {}; }
	bool pairing_active() const override { return pairing; }
	unsigned advertisements = 0;
	unsigned stops = 0;
	bool fail_init = false;
	bool overflow = false;
	std::deque<ble::bluetooth_event> events;
	std::vector<std::uint8_t> sent;
	ble::session_t session = 0;
	bool busy = false;
	ble::session_t receive_session = 0;
	std::optional<bluetooth_measurement::snapshot> measurement;
	std::optional<bluetooth_battery::snapshot> battery;
	ble::status update_battery(const bluetooth_battery::snapshot &value) override
	{
		battery = value;
		return {};
	}
	ble::status update_measurement(const bluetooth_measurement::snapshot &value) override
	{
		measurement = value;
		return {};
	}
	void reset_measurement() override
	{
		measurement.reset();
		battery.reset();
	}
	void set_receive_session(ble::session_t value) override
	{
		receive_session = value;
	}

	ble::status init() override
	{
		if (fail_init)
		{
			return ble::fail(ble::component::bluetooth, ble::error_code::io);
		}

		return {};
	}

	void stop() override {}

	ble::status start_advertise() override
	{
		++advertisements;
		return {};
	}

	ble::status stop_advertise() override
	{
		++stops;
		return {};
	}

	ble::status send(ble::data_view data, ble::session_t target) override
	{
		if (busy)
		{
			return ble::fail(ble::component::bluetooth, ble::error_code::busy);
		}

		sent.assign(data.data, data.data + data.size);
		session = target;
		return {};
	}

	ble::result<ble::bluetooth_event> poll(std::uint32_t) override
	{
		if (overflow)
		{
			return ble::fail(ble::component::bluetooth, ble::error_code::overflow);
		}

		if (!events.empty())
		{
			const auto event = events.front();
			events.pop_front();
			return event;
		}

		return ble::bluetooth_event{};
	}
};

int main()
{
	fake_uart transport;
	fake_bluetooth bluetooth;
	ble_bridge::bridge_codec codec;
	ble::bridge_config config{
		.transport = transport,
		.bluetooth = bluetooth,
		.codec = codec,
		.uptime_ms = []{ return now_ms; },
		.write_timeout_ms = 0
	};
	ble::bridge_service bridge{config};
	const auto push = [&](const ble_bridge::frame &frame)
	{
		std::vector<std::uint8_t> bytes(ble_bridge::wire_frame_capacity);
		bytes.resize(codec.encode(frame, bytes).value());
		transport.chunks.push_back(bytes);
	};
	const auto handshake = [&](std::uint32_t session)
	{
		push(ble_bridge::frame{
			.type = ble_bridge::frame_type::hello,
			.sequence = 19,
			.session = session
		});
		require(bridge.poll().has_value());
		require(transport.written.back().type == ble_bridge::frame_type::pairing_state);
		require(transport.written.back().size == 1 && transport.written.back().payload[0] == 0);
		transport.written.pop_back();
		require(transport.written.back().type == ble_bridge::frame_type::ready);
		require(transport.written.back().sequence == 19 && transport.written.back().session == session);
	};
	const auto encode = [&](ble_bridge::frame_type type)
	{
		std::vector<std::uint8_t> bytes(ble_bridge::wire_frame_capacity);
		const auto size = codec.encode(ble_bridge::frame{
			.type = type,
			.session = 25
		}, bytes).value();
		bytes.resize(size);
		return bytes;
	};
	const auto advertise = encode(ble_bridge::frame_type::advertise);
	const auto stop = encode(ble_bridge::frame_type::stop_advertise);

	require(bridge.poll().error().code == ble::error_code::not_initialized);
	require(bridge.start().has_value());
	require(bridge.poll().has_value());
	require(transport.written.back().type == ble_bridge::frame_type::hello && transport.written.back().session == 0);
	require(bridge.next_wakeup_ms() == 1000u);
	const auto initial_requests = transport.written.size();
	now_ms = 999;
	require(bridge.next_wakeup_ms() == 1u);
	require(bridge.poll().has_value());
	require(transport.written.size() == initial_requests);
	now_ms = 1000;
	require(bridge.poll().has_value());
	require(transport.written.size() == initial_requests + 1);
	transport.chunks.push_back(advertise);
	require(bridge.poll().has_value());
	require(bluetooth.advertisements == 0);
	require(transport.written.back().payload[0] == static_cast<std::uint8_t>(ble_bridge::ack_code::not_ready));
	handshake(25);
	bluetooth_measurement::snapshot measurement{
		.flags = bluetooth_measurement::sensor_valid,
		.sensor_sequence = 42,
		.temperature = -125,
		.pressure = 1000000,
		.sensor_lifetime_ms = 600000
	};
	const auto measurement_bytes = bluetooth_measurement::encode(measurement);
	ble_bridge::frame publication{
		.type = ble_bridge::frame_type::measurement,
		.sequence = 123,
		.session = 25,
		.size = static_cast<ble_bridge::length_type>(measurement_bytes.size())
	};
	std::copy(measurement_bytes.begin(), measurement_bytes.end(), publication.payload.begin());
	push(publication);
	require(bridge.poll().has_value());
	require(bluetooth.measurement && bluetooth.measurement->sensor_sequence == 42);
	require(transport.written.back().sequence == 123 && transport.written.back().payload[0] == 0);
	publication.payload[0] = 2;
	push(publication);
	require(bridge.poll().has_value());
	require(transport.written.back().payload[0] == static_cast<std::uint8_t>(ble_bridge::ack_code::invalid_request));
	publication.payload[0] = 1;
	publication.session = 24;
	push(publication);
	require(bridge.poll().has_value());
	require(transport.written.back().payload[0] == static_cast<std::uint8_t>(ble_bridge::ack_code::not_ready));
	handshake(25);
	require(!bluetooth.measurement);
	handshake(26);
	require(!bluetooth.measurement);
	const auto battery_bytes = bluetooth_battery::encode({});
	publication.type = ble_bridge::frame_type::battery;
	publication.session = 26;
	publication.size = battery_bytes.size();
	std::copy(battery_bytes.begin(), battery_bytes.end(), publication.payload.begin());
	push(publication);
	require(bridge.poll().has_value() && bluetooth.battery.has_value());
	require(transport.written.back().payload[0] == static_cast<std::uint8_t>(ble_bridge::ack_code::ok));
	publication.payload[2] = 101;
	push(publication);
	require(bridge.poll().has_value());
	require(transport.written.back().payload[0] == static_cast<std::uint8_t>(ble_bridge::ack_code::invalid_request));
	publication.payload[2] = 0;
	publication.session = 25;
	push(publication);
	require(bridge.poll().has_value());
	require(transport.written.back().payload[0] == static_cast<std::uint8_t>(ble_bridge::ack_code::not_ready));
	handshake(25);
	require(!bluetooth.battery);
	transport.chunks.emplace_back(advertise.begin(), advertise.begin() + 5);
	require(bridge.poll().has_value());
	require(bluetooth.advertisements == 0);
	require(bridge.poll().has_value());
	transport.chunks.emplace_back(advertise.begin() + 5, advertise.end());
	require(bridge.poll().has_value());
	require(bluetooth.advertisements == 1);

	auto combined = advertise;
	combined.insert(combined.end(), stop.begin(), stop.end());
	transport.chunks.push_back(combined);
	require(bridge.poll().has_value());
	require(bluetooth.advertisements == 2 && bluetooth.stops == 1);

	transport.chunks.emplace_back(ble_bridge::wire_frame_capacity + 20, 1);
	transport.chunks.back().push_back(0);
	transport.chunks.back().insert(transport.chunks.back().end(), advertise.begin(), advertise.end());
	while (!transport.chunks.empty())
	{
		require(bridge.poll().has_value());
	}
	require(bluetooth.advertisements == 3);

	transport.chunks.emplace_back(advertise.begin(), advertise.begin() + 4);
	require(bridge.poll().has_value());
	transport.io_error = true;
	require(bridge.poll().error().code == ble::error_code::io);
	transport.chunks.push_back(advertise);
	require(bridge.poll().has_value());
	require(bluetooth.advertisements == 4);
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
