Malibushko/TrackNode/(commit log)

2026-08-27 Setup for STM32F411CEU6 and blink led bare-metal
2026-09-12 UART + printf for HAL
2026-09-12 ADC experiments
2026-09-13 Add status led & further code refactor
2026-09-13 Implement UART reading and simple echo terminal
2026-09-14 Add simple binary protocol for UART
2026-09-14 Add I2C bus + I2C device wrappers
2026-09-15 BMP280 driver finished
2026-09-20 Add SPI Bus + Spi device classes
2026-09-21 Log sensor data to file & add simple command to check log
2026-09-22 Finish DMA for uart
2026-09-24 Fault policy, tests, restart if sensor stops reading data
2026-09-26 Add GNSS to sample
2026-09-27 Add sx126x driver
2026-09-30 Add low power mode & support it for gnss service
2026-10-01 Sample board supply through calibrated VREFINT and expose GET VOLTAGE
2026-10-01 Add command for changing power mode
2026-10-06 Separate radio publication filtering from telemetry routing
2026-10-06 Extract module configuration chain from firmware main
2026-10-06 Replace Arduino BLE scaffold with Zephyr and share bridge contract
2026-10-07 Implement shared UART bridge codec with CRC and COBS
2026-10-07 Implement synchronous Zephyr UART with interrupt buffering
2026-10-07 Add incremental UART bridge parser and integrate advertising smoke commands
2026-10-07 Setup uart for BLE
2026-10-11 Add Windows BLE workbench and bounded STM32 firmware log stream
2026-10-11 Negotiate STM32-owned bridge sessions after restart and reconnect
2026-10-11 Document automatic Bluetooth idle power management
2026-10-11 Isolate UART receive errors from transmit failures
2026-10-12 Move Bluetooth bridge to USART1 and disable UART console
2026-10-13 Add USB device owner and CDC byte stream with ST stack integration
2026-10-13 Introduce serial device interface and restore USB CDC console with VBUS detection
2026-10-14 Add battery monitoring, BLE Battery Service and stable charge display
2026-10-14 Add live battery chart with USB timeline and CSV export
2026-10-15 Add background battery sampling and quality-aware charge estimates
2026-10-22 Add persistent SPI NOR telemetry journal
    Replace the RAM history ring with a flash-backed journal on W25Qxx-class
    SPI NOR so unacknowledged samples survive restarts.
    - Ring of 4 KiB sectors with generation headers, 64-byte records,
    commit markers and one-way ACK state bits
    - Session ID derived from flash at boot; no sector is erased on startup
    - Journal is optional: without a working flash the node runs with live
    telemetry and history replies ERR HISTORY_STORAGE
    - Fix oldest-pending lookup after ring wrap and stop reads past the
    requested range (ACK no longer scans the whole chip)
    - Tolerate corrupted records at startup, seal sectors after failed
    programs, verify header generation
    -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
2026-10-29 Rework power mode to interrupts
2026-10-29 Disable LED by default
2026-10-29 Rework nRF to EXTI instead of polling for power saving
2026-10-29 Support STOP for STM32 and BLE chip for power saving
2026-10-30 Disable unused features at build time, rename power measuring tool
